coloradoprintingproject/twoolhead/media/photo/crowdsupply_campaign_images/twaz-6-printing-brace1.jpg

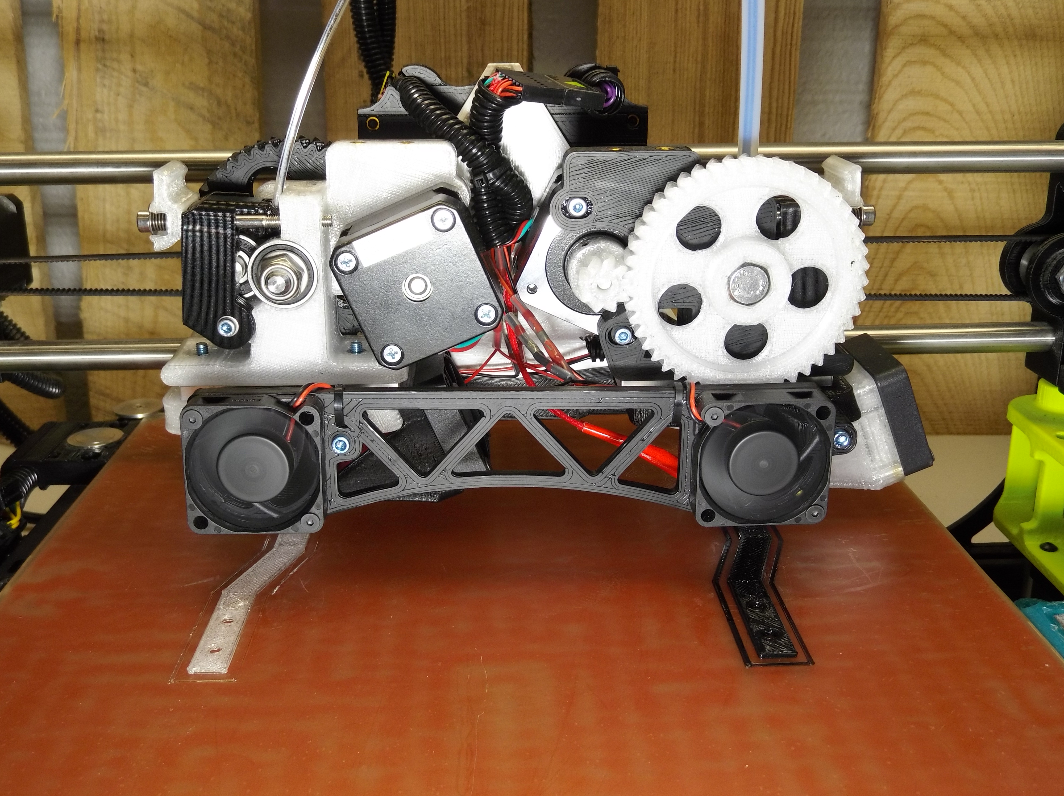
media/photo/crowdsupply_campaign_images/twaz-6-printing-brace1.jpg
