coloradoprintingproject/twoolhead/docs/twoolhead_greeting_letter.odt

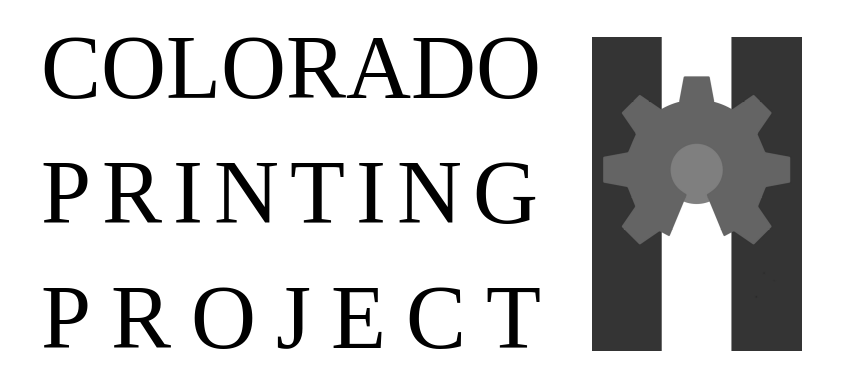
[picture p3: figure]

Thank you for purchasing the Twoolhead, and for supporting the development being done by the Colorado Printing Project.

This is version 1.1 of the Thoolhead, the first to incorporate E3D hotends nickel plated copper nozzles. Your Twoolhead is currently loaded with ABS filament, and the package contains 2 nozzle cleaning brushes that were printed simultaneously using your Twoolhead as a final quality check prior to shipping.

To get started, please download the Twoolhead source from Github by navigating to the link below and clicking on the green “clone or download” button. This will include a complete startup guide in the getting_started folder, along with the part files, bill of materials and all other source materials created during development. There are also video tutorials up on the Colorado Printing Project’s YouTube chanel.

https://github.com/coloradoprintingproject/twoolhead

The Twoolhead will work with pretty much any slicing software, but needs custom start and end gcode which is included in the startup guide.

If you have any questions or difficulties getting started, please get in touch with me directly at bam@coloradoprintingproject.org.

Again, thank you for your support of the Colorado Printing Project

-Brent MacKenzie (bam)

Founder

Colorado Printing Project, Ltd.

Copyright 2018 by the Colorado Printing Project CC-BY-SA 4.0
