coloradoprintingproject/twoolhead/media/video_outline.odt

1. Opening: Batch 3D printing is awesome, get in on it.

Image: Show clips of existing 3D printer clusters (lulzbot, Prusa research) and cool 3D printing projects (LEGO longboard, OpenBCI).

Text: 3D printing for small batch production is quickly lowering the barrier to entry for getting a product to market in both cost and lead time, speeding up innovation and encouraging local manufacturing.

2. Beauty shot of Twoolhead. About ten seconds.

Image: Crowdsupply image of twoolhead, then short video of printing plate of gears or something.

Text: The Twoolhead builds on one of the most reliable and versatile 3D printers available today and doubles it’s output.

3. Detail 1: About 15 seconds.

Image: Timelapse of twoolhead install on TAZ 6

Text: The twoolhead integrates seamlessly with LulzBot(R) TAZ 5 and 6 3D printers, some of the most heavily tested and used printers on the market. The Twoolhead comes with everything you need to get started in less than 20 minutes.

4. Detail 2: Output & materials. About 15 seconds.

Image: short clips of Twoolhead printing / finishing lots of different parts, gears, fan mounts, bottle openers, octopi, etc.

Text: With an output of nearly 700 grams per day of consumer grade printed plastic parts, the twoolhead makes small batch production easier than ever

Image: Image of Twoolhead on TAZ 6 with stacks of filament around it

Text: The twoolhead is capable of printing with nearly all FFF materials currently available, making it easy to print just the right parts as soon as you need them

5. Detail 3: Open-source. About 15 seconds.

Image: timelapse of twoolhead being assembled in blender

Text: The Twoolhead is fully open-source, and was developed using open source tools.

Image: Timelapse of browsing repo, including logo source and freeCAD source

Text: Having access to the source means that you can tweak, modify and upgrade your printhead over time

  6. Explain who you are… About 15 seconds.

Image: Gopro video

Audio: Heya this is bam with Colorado Printing Project, which is a company I started about 6 months ago designed to speed up the open source development of production oriented 3D printing. I was fortunate enough to spend the last 4 and a half years working in and designing parts for production in the cluster up at Aleph Object’s headquarters. This is a fantastic technology, and I really want to ensure that batch printing technology moves forward quickly and in a way where it isn’t crippled by patents.

The first step towards a fully production oriented machine has been to outfit one of the best production printers in the world with the twoolhead, doubling it’s output. I’m currently on the 3rd iteration prototype and the pre-production testing is going well. I have vendors lined up and am ready to produce the first batch of Twoolheads.

6. Make it clear that you need the viewers’ help, both in pledging to the project and in spreading the word. End with a clear call to action. About 15 seconds.

Image: Continued from previous.

Audio: I need your help turning this phase of the project into a product, and I will need help in order to continue development of production oriented 3D printing technology. Thanks for supporting the project and happy printing

End: show text of all required attribution
