coloradoprintingproject/twoolhead/media/logo/coprintpro_logo.pdf

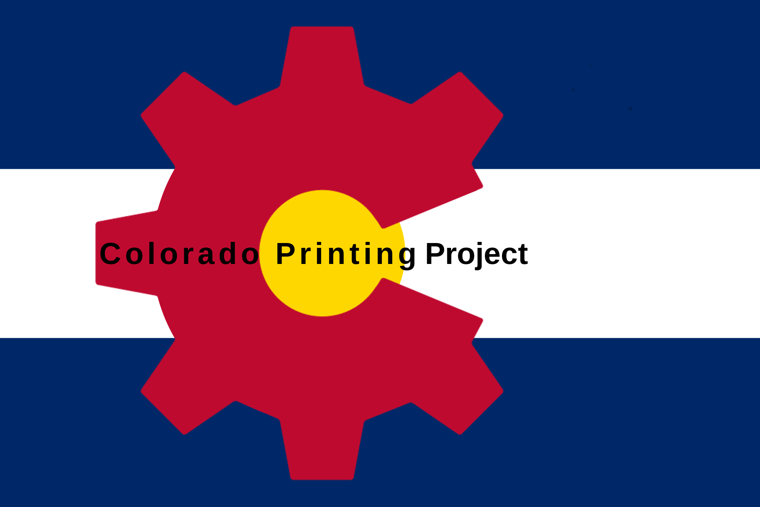
[picture p4: page 1]

Colorado Printing Project
