coloradoprintingproject/twoolhead/docs/twaz_vs_injection-molding.png

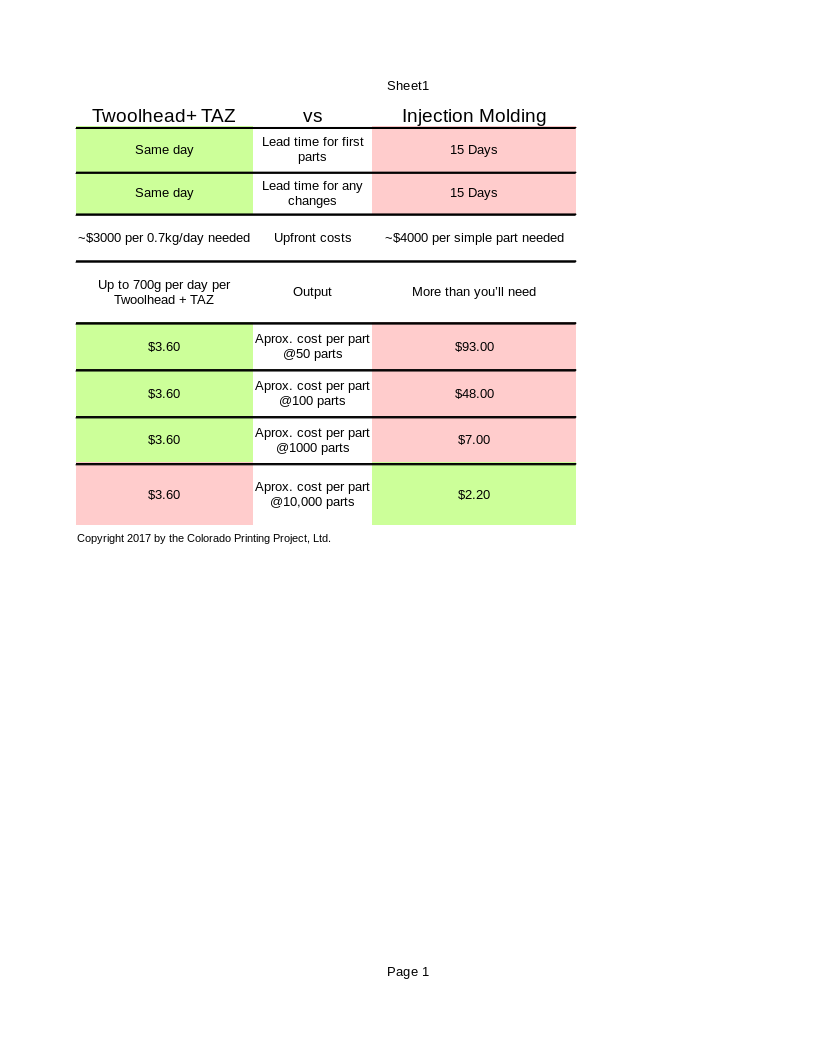
docs/twaz_vs_injection-molding.png
