coloradoprintingproject/twoolhead/media/cad_render/embeefened_twoolhead.JPG

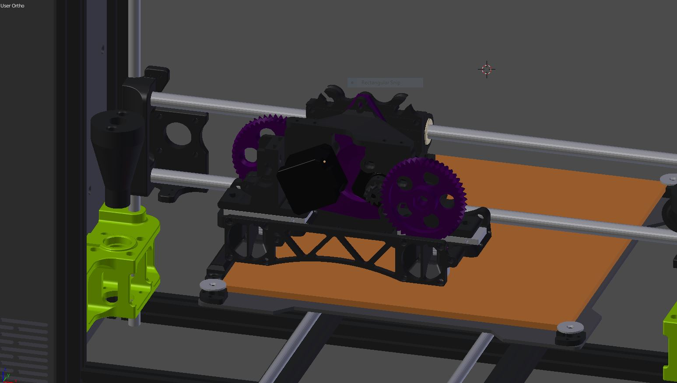
media/cad_render/embeefened_twoolhead.JPG
