coloradoprintingproject/twoolhead/media/cad_render/twoolhead_bracing_blender_mockup.JPG

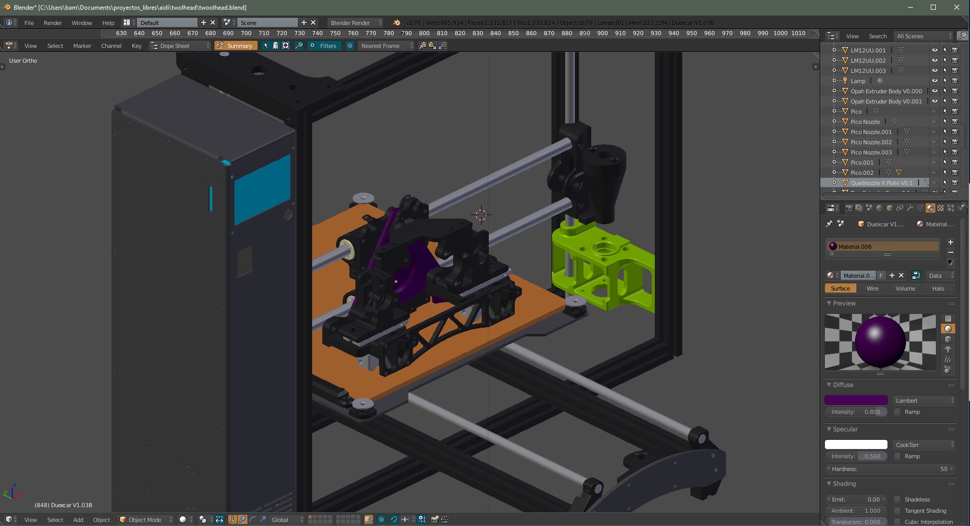
media/cad_render/twoolhead_bracing_blender_mockup.JPG
