coloradoprintingproject/twoolhead/media/new-cura-machine-settings.png

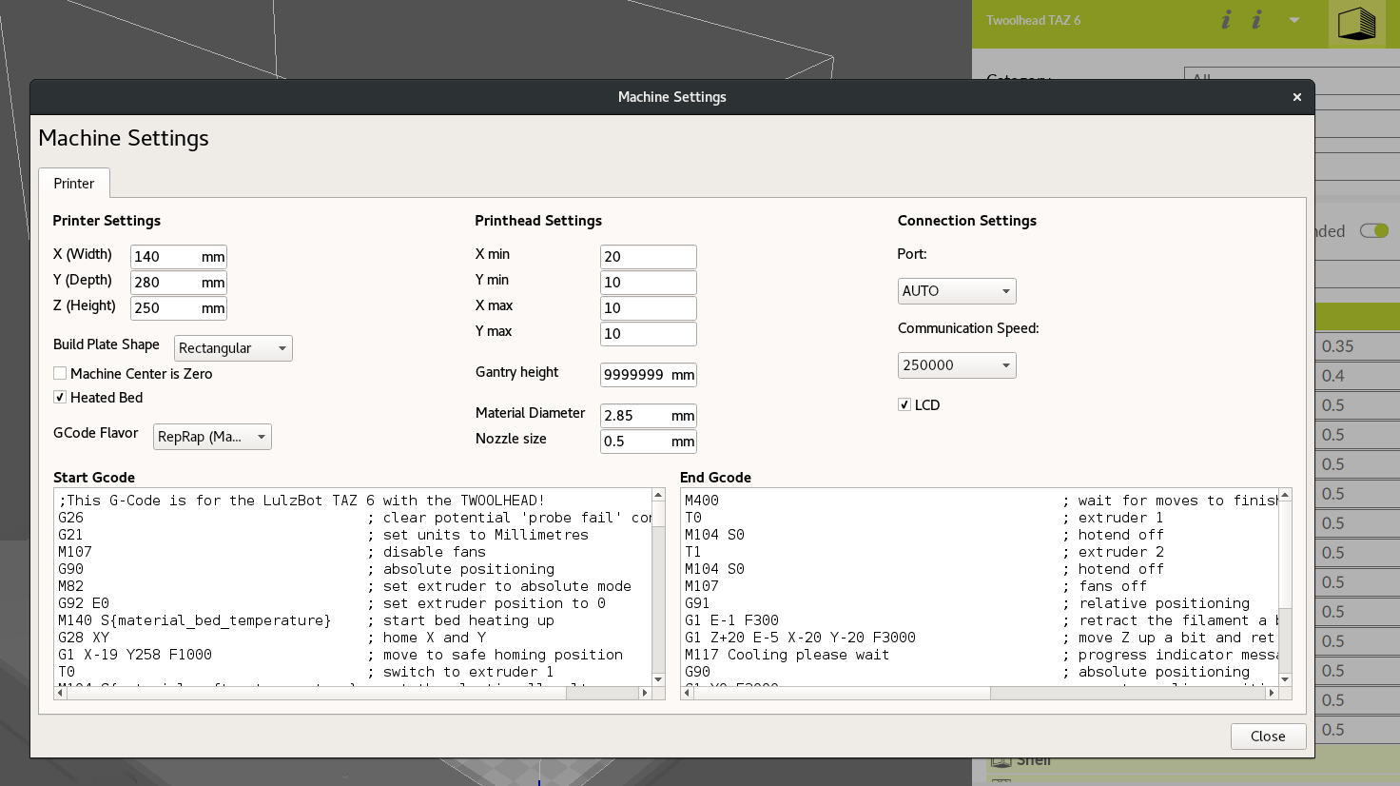
media/new-cura-machine-settings.png
