coloradoprintingproject/twoolhead/media/photo/alpha_prototype_images/twoolhead_front.jpg

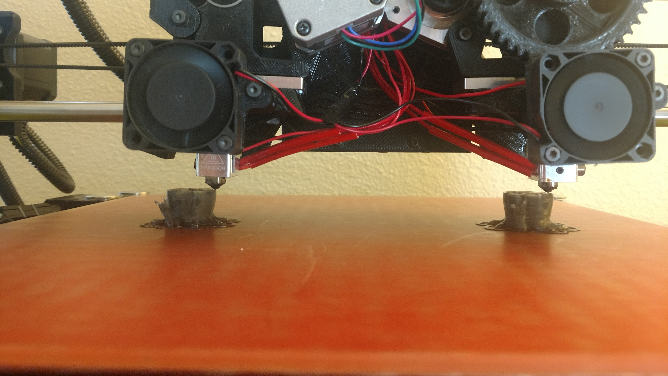
media/photo/alpha_prototype_images/twoolhead_front.jpg
