coloradoprintingproject/twoolhead/media/photo/alpha_prototype_images/twoolhead_top.jpg

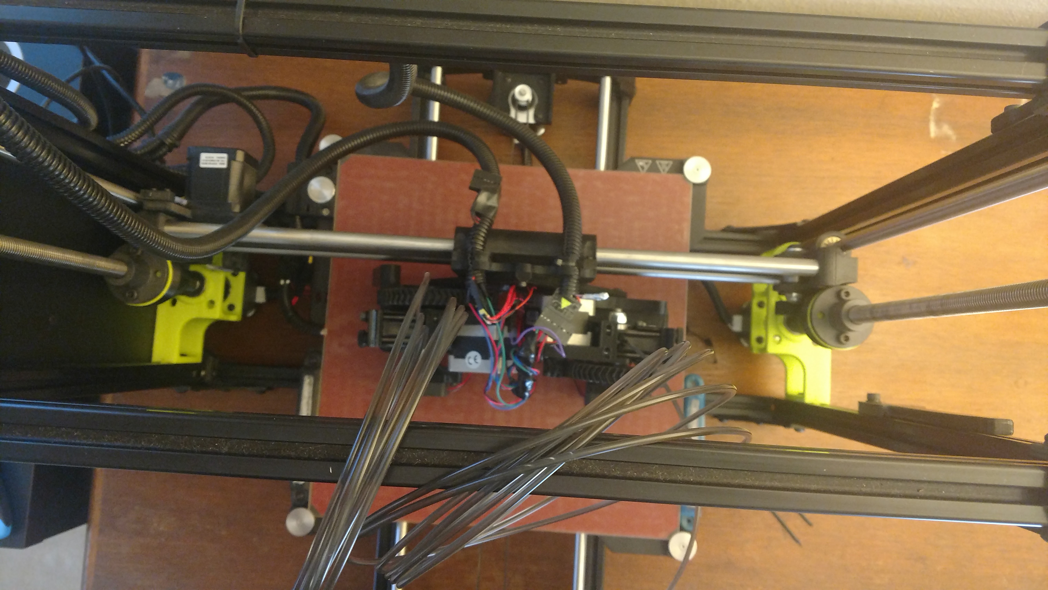
media/photo/alpha_prototype_images/twoolhead_top.jpg
