coloradoprintingproject/twoolhead/media/photo/alpha_prototype_images/twoolheat_front_wide.jpg

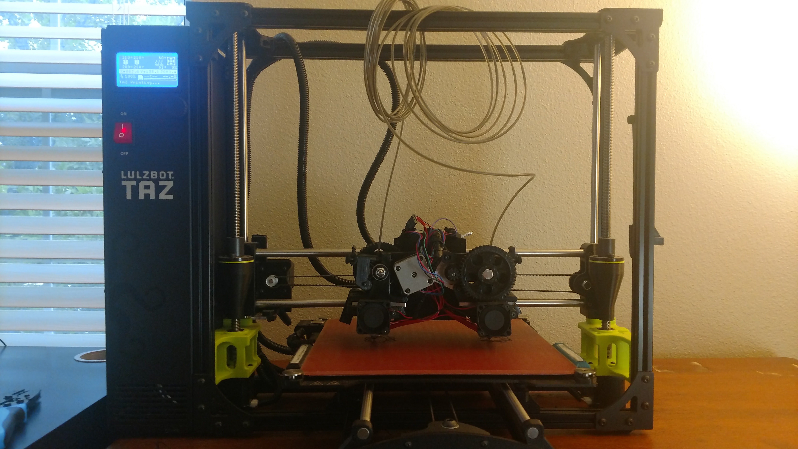
media/photo/alpha_prototype_images/twoolheat_front_wide.jpg
