coloradoprintingproject/twoolhead/media/photo/beta_prototype_images/1.jpg

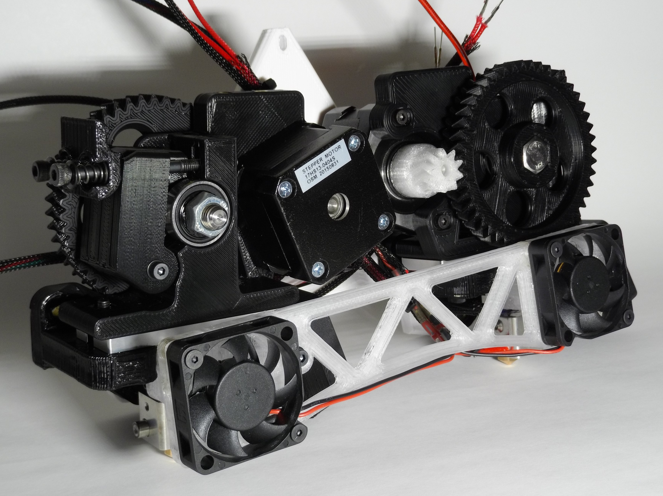
media/photo/beta_prototype_images/1.jpg
