coloradoprintingproject/twoolhead/media/photo/beta_prototype_images/2.jpg

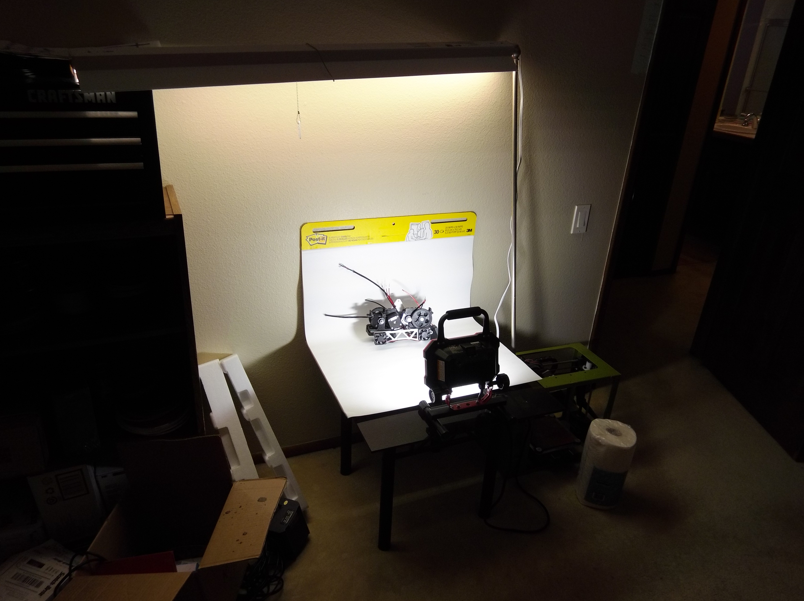
media/photo/beta_prototype_images/2.jpg
