coloradoprintingproject/twoolhead/media/photo/beta_prototype_images/3.jpg

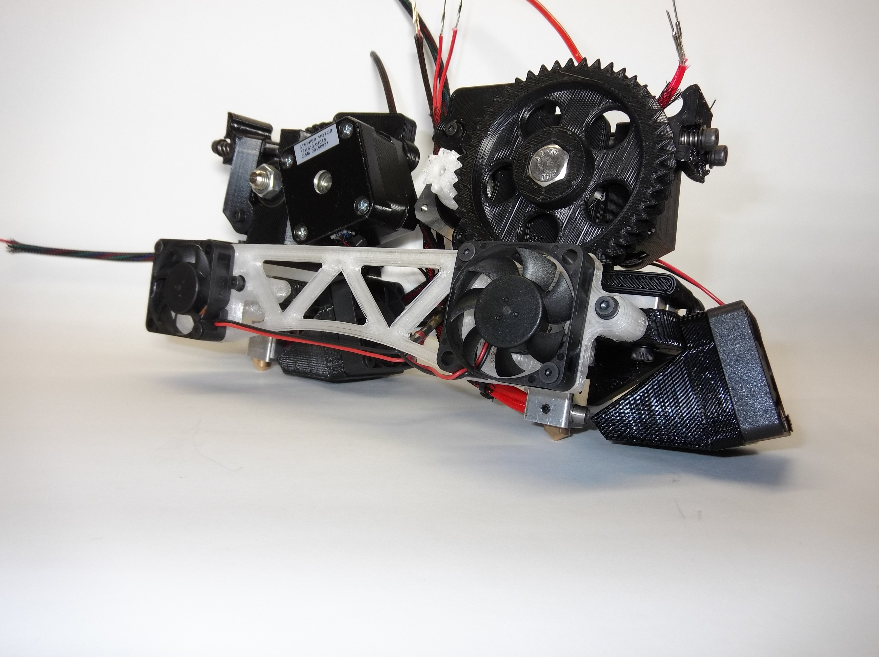
media/photo/beta_prototype_images/3.jpg
