coloradoprintingproject/twoolhead/media/photo/beta_prototype_images/4.jpg

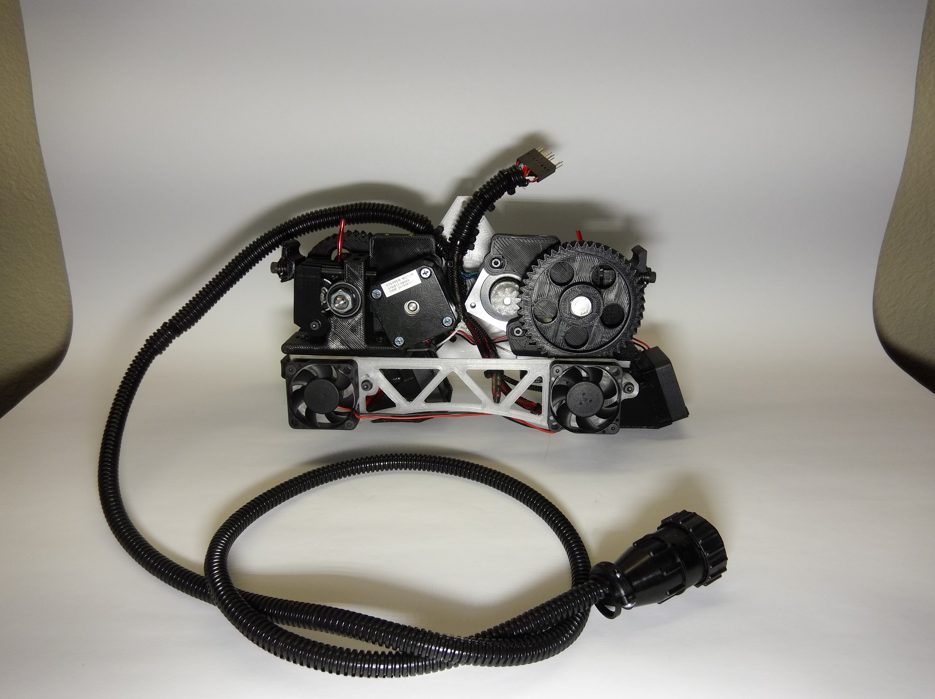
media/photo/beta_prototype_images/4.jpg
