coloradoprintingproject/twoolhead/media/photo/beta_prototype_images/5.jpg

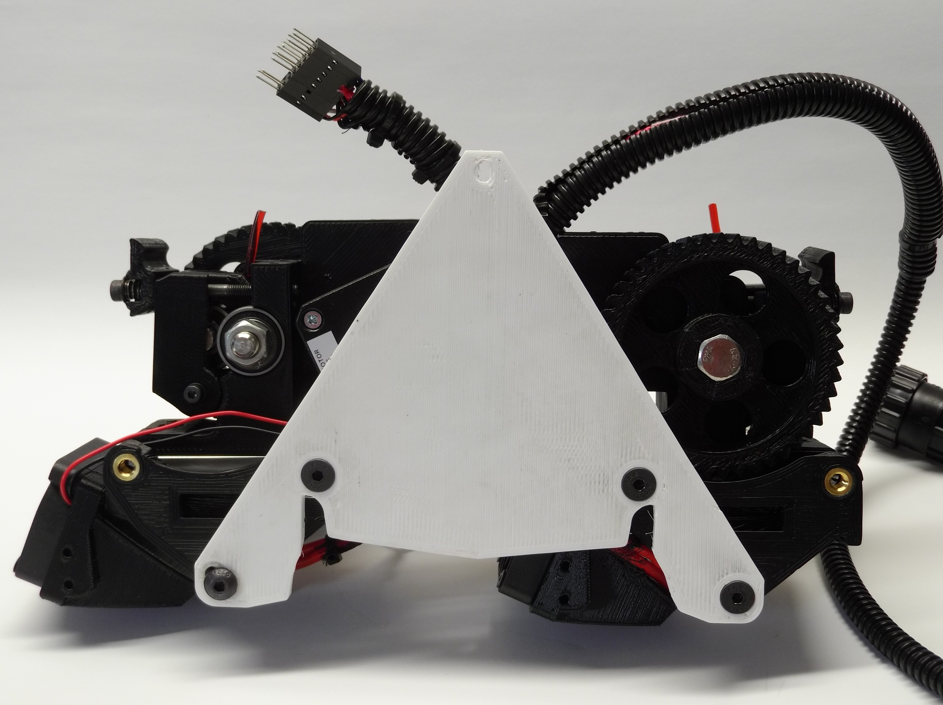
media/photo/beta_prototype_images/5.jpg
