coloradoprintingproject/twoolhead/media/photo/beta_prototype_images/6.jpg

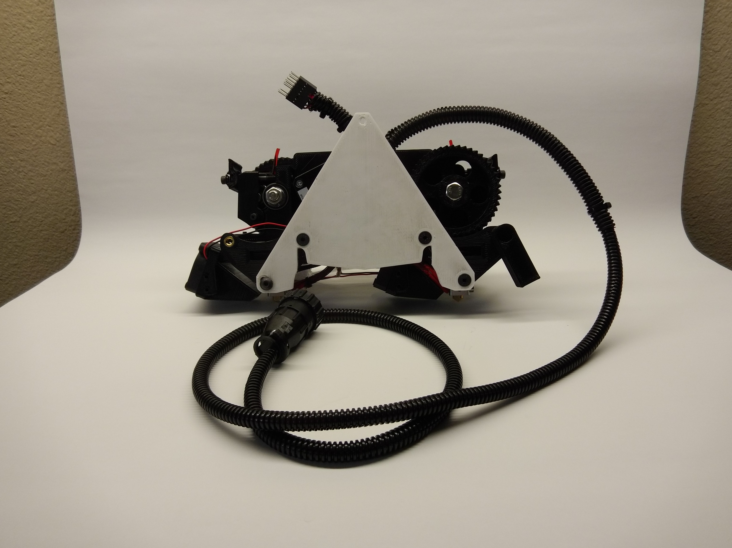
media/photo/beta_prototype_images/6.jpg
