coloradoprintingproject/twoolhead/media/photo/beta_prototype_images/7.jpg

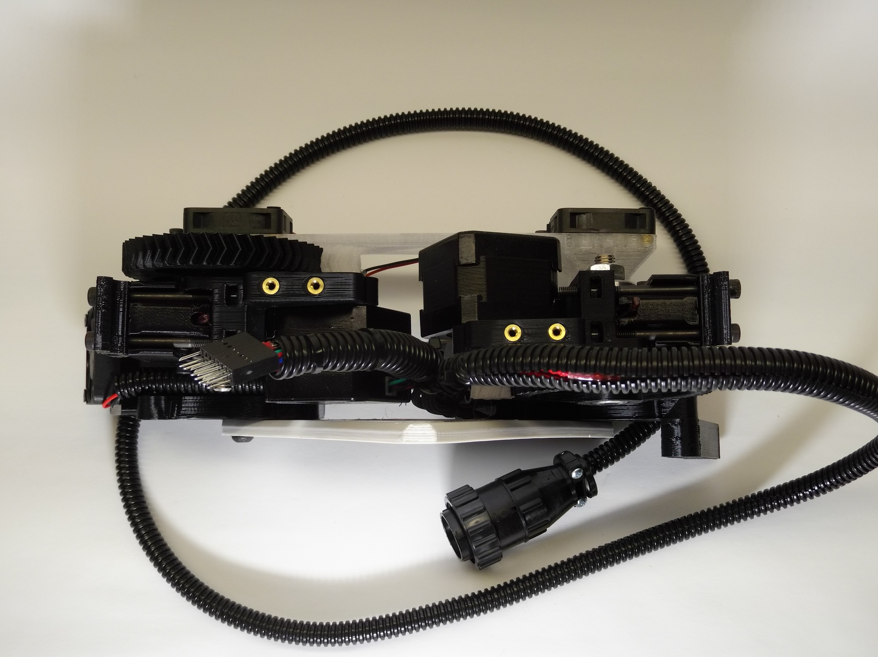
media/photo/beta_prototype_images/7.jpg
