coloradoprintingproject/twoolhead/media/photo/beta_prototype_images/crowdsupply_prelaunch_image.jpg

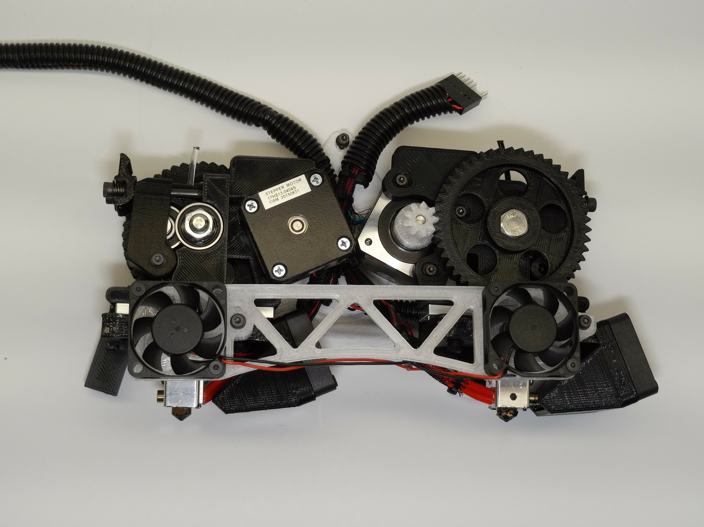
media/photo/beta_prototype_images/crowdsupply_prelaunch_image.jpg
