coloradoprintingproject/twoolhead/media/photo/crowdsupply_campaign_images/a-wild-twoolhead.jpeg

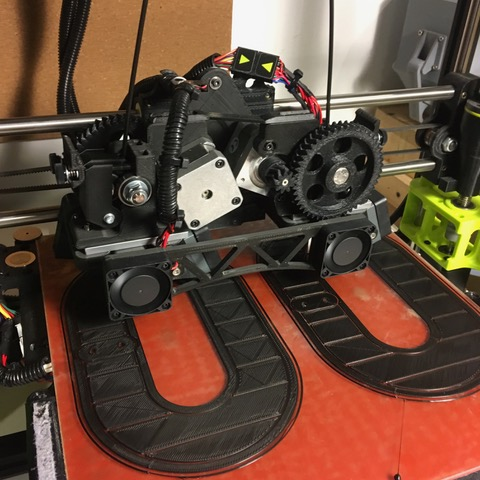
media/photo/crowdsupply_campaign_images/a-wild-twoolhead.jpeg
