coloradoprintingproject/twoolhead/media/photo/crowdsupply_campaign_images/blender-mesh-view.png

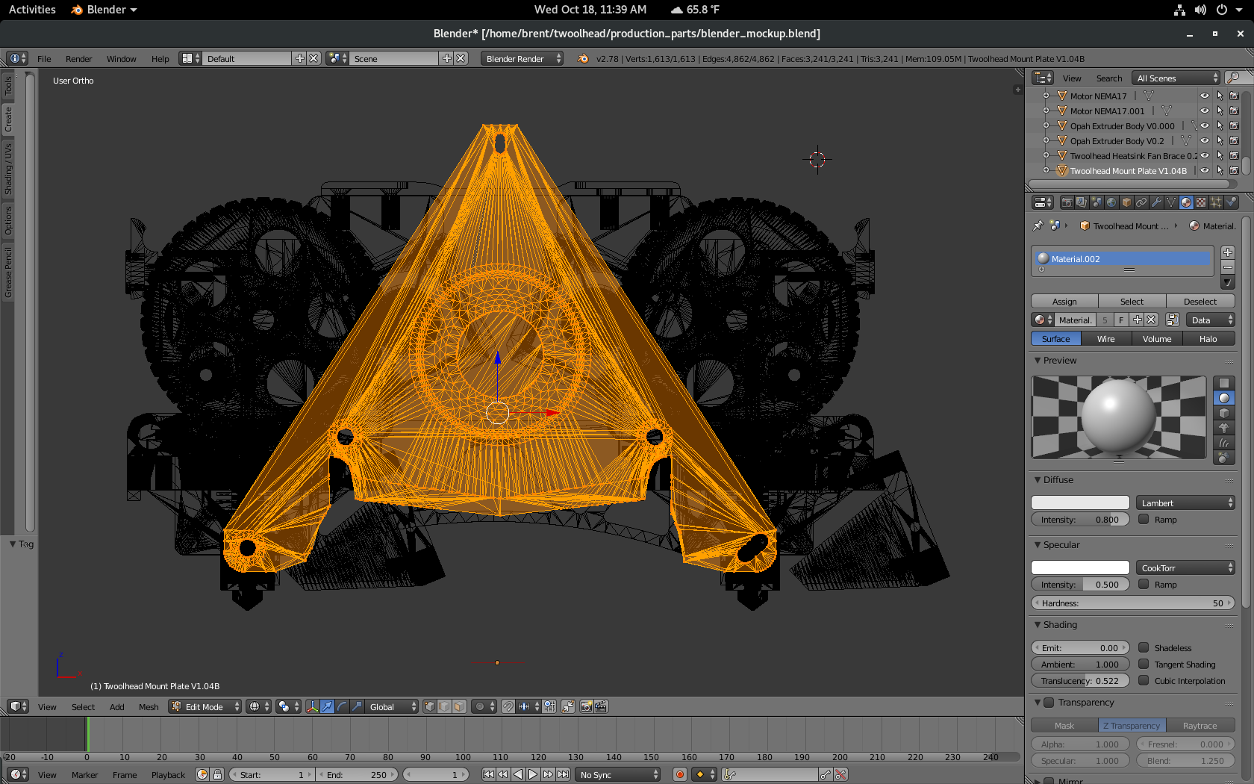
media/photo/crowdsupply_campaign_images/blender-mesh-view.png
