coloradoprintingproject/twoolhead/media/photo/crowdsupply_campaign_images/blender-mockup.png

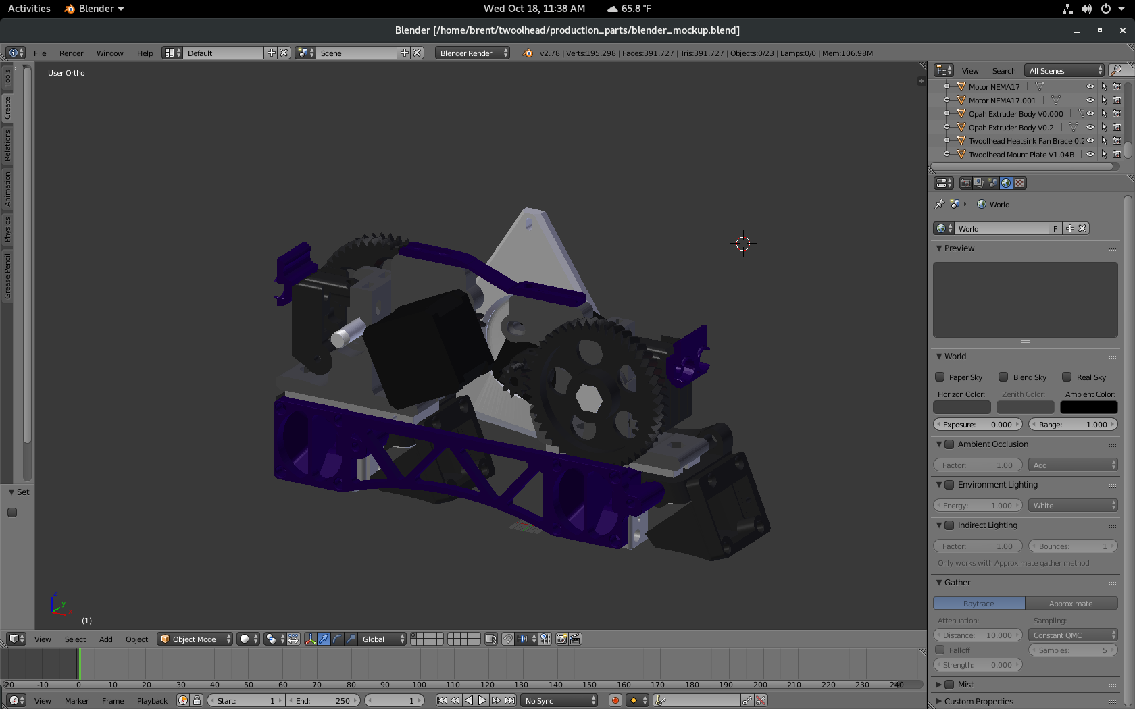
media/photo/crowdsupply_campaign_images/blender-mockup.png
