coloradoprintingproject/twoolhead/media/photo/crowdsupply_campaign_images/freecad-screenshot.png

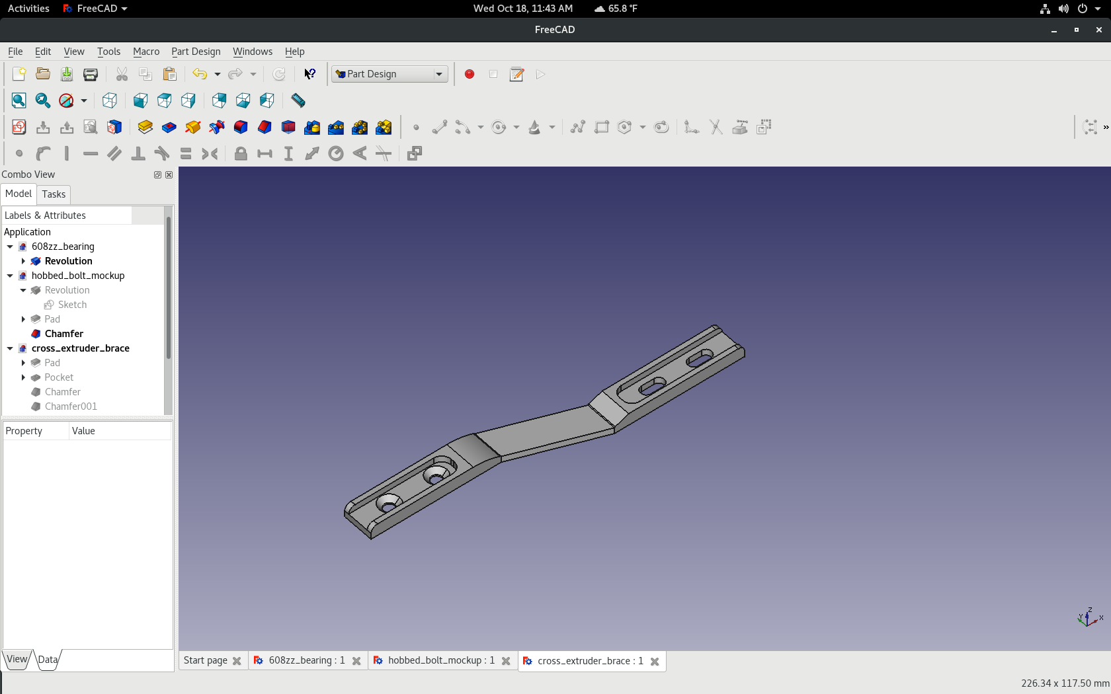
media/photo/crowdsupply_campaign_images/freecad-screenshot.png
