coloradoprintingproject/twoolhead/media/photo/crowdsupply_campaign_images/metric-blue-and-colorado-purp.jpg

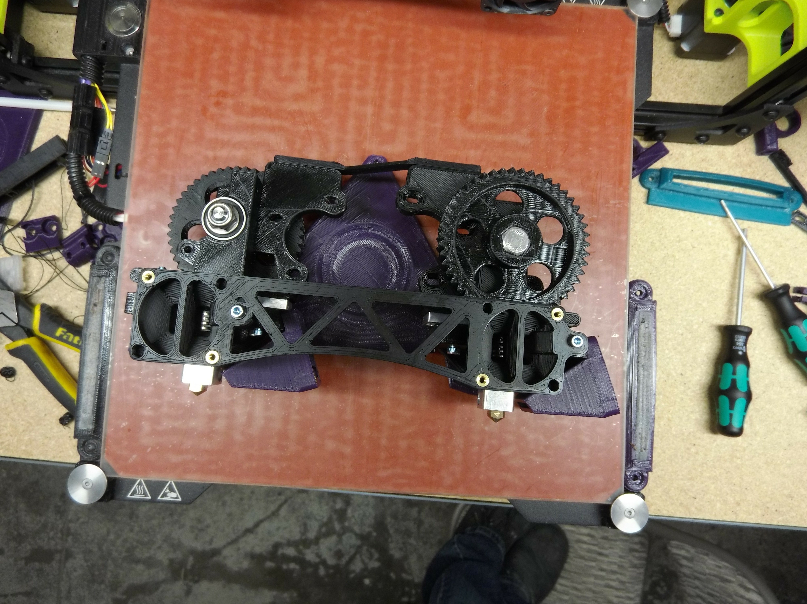
media/photo/crowdsupply_campaign_images/metric-blue-and-colorado-purp.jpg
