coloradoprintingproject/twoolhead/media/photo/crowdsupply_campaign_images/twaz-6-mounted2.jpg

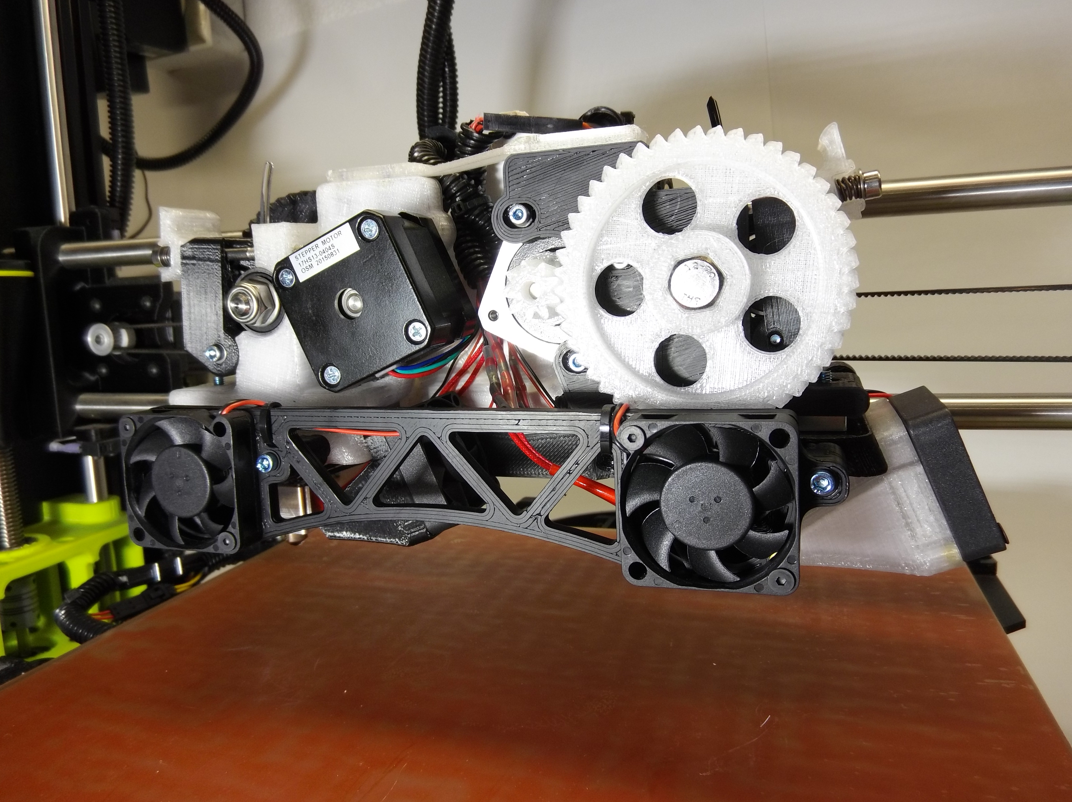
media/photo/crowdsupply_campaign_images/twaz-6-mounted2.jpg
