coloradoprintingproject/twoolhead/media/photo/crowdsupply_campaign_images/twaz-6-mounted-front-close.jpg

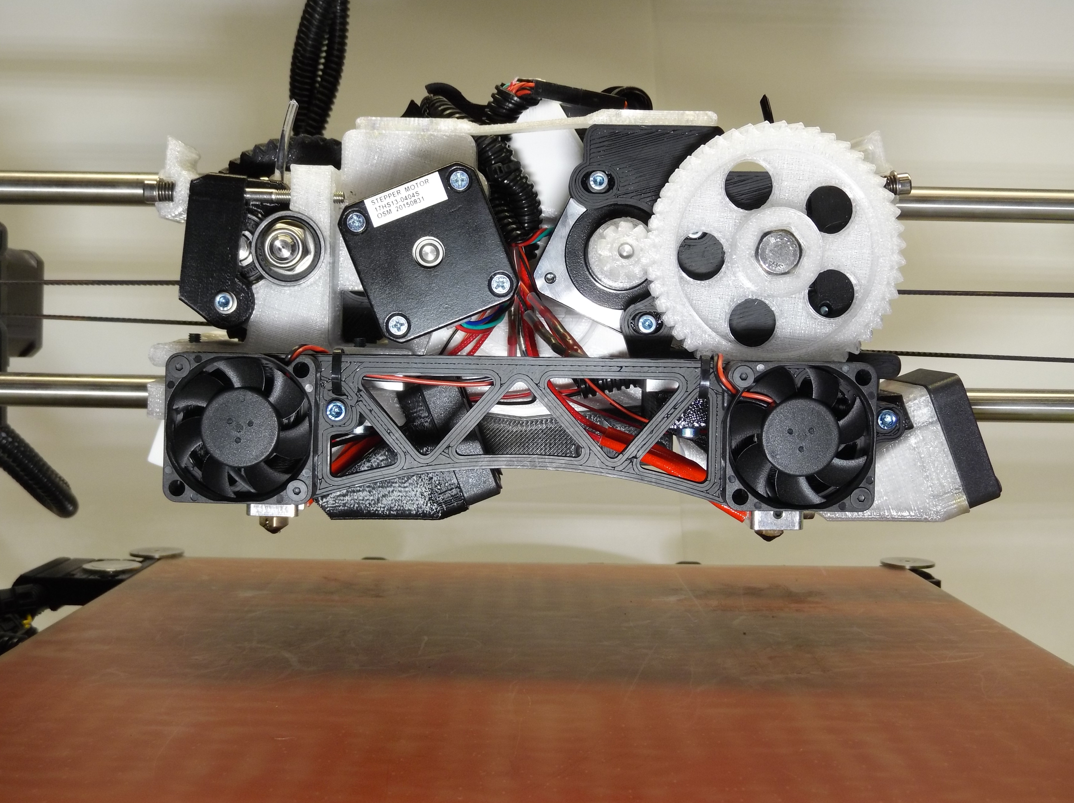
media/photo/crowdsupply_campaign_images/twaz-6-mounted-front-close.jpg
