coloradoprintingproject/twoolhead/media/photo/crowdsupply_campaign_images/twaz-6-mounted-front-left.jpg

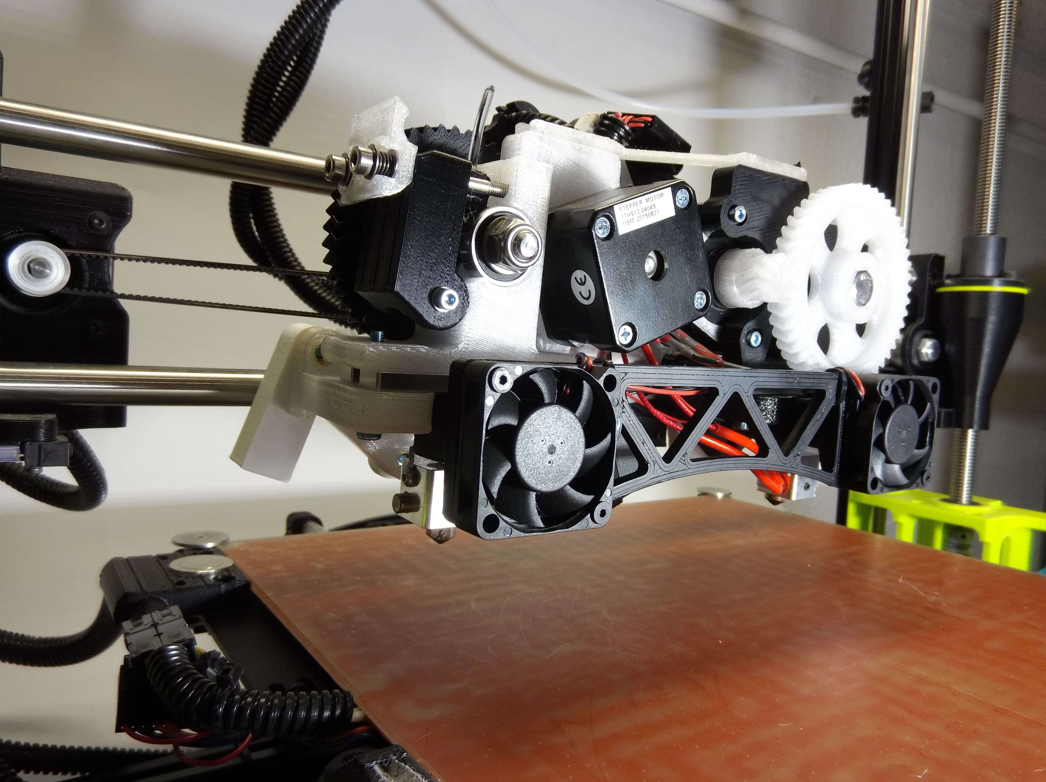
media/photo/crowdsupply_campaign_images/twaz-6-mounted-front-left.jpg
