coloradoprintingproject/twoolhead/media/photo/crowdsupply_campaign_images/twaz-6-mounted-front.jpg

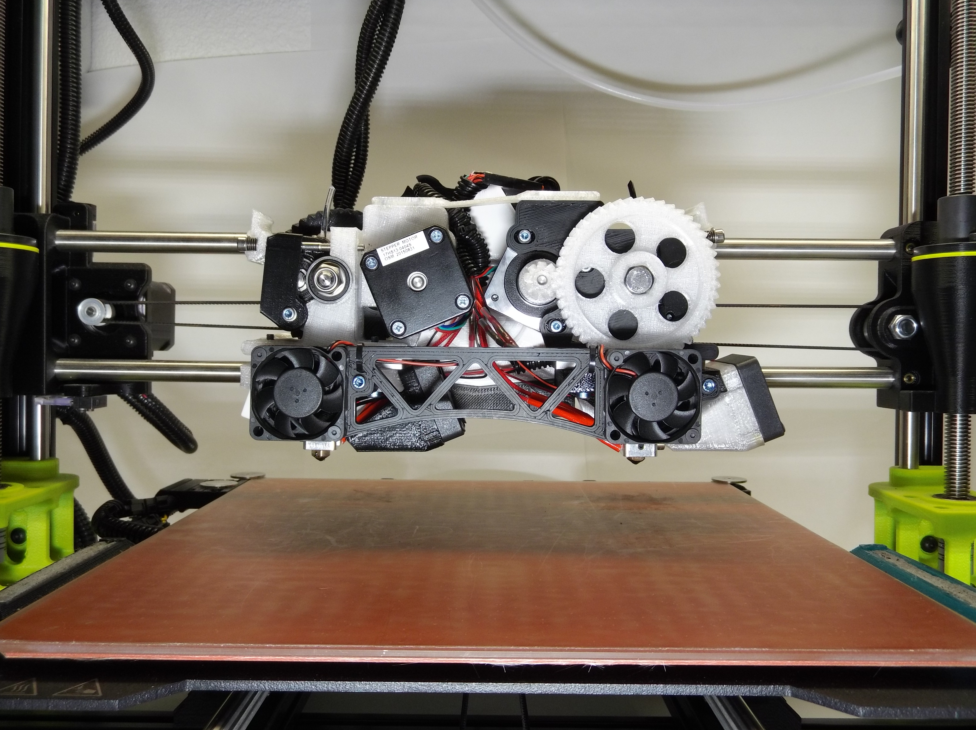
media/photo/crowdsupply_campaign_images/twaz-6-mounted-front.jpg
