coloradoprintingproject/twoolhead/media/photo/crowdsupply_campaign_images/twaz-6-mounted-top.jpg

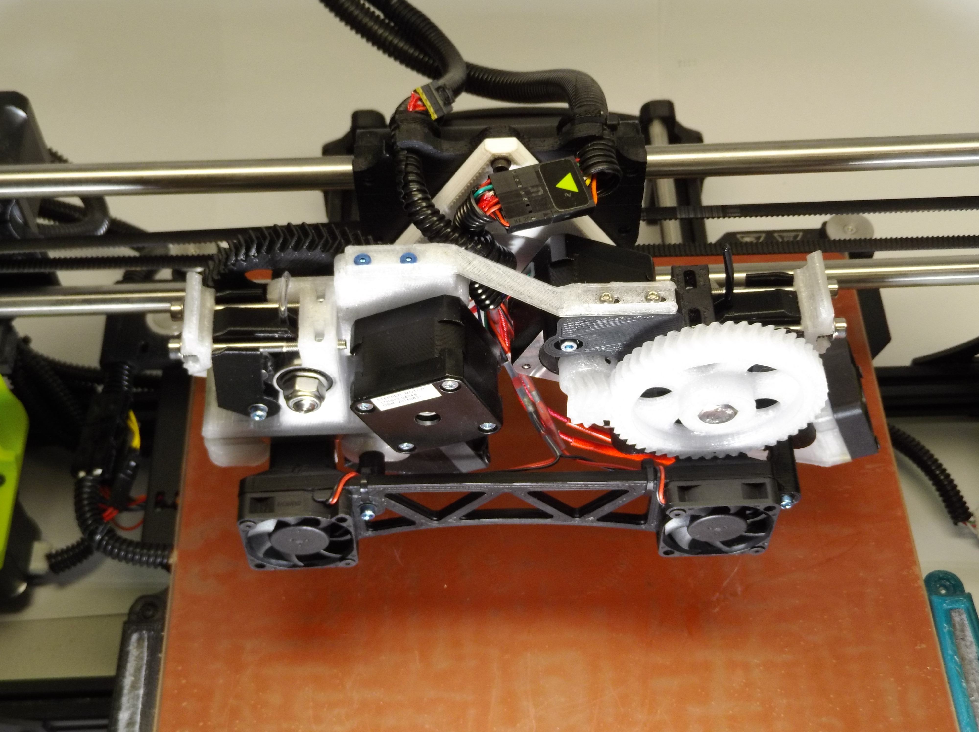
media/photo/crowdsupply_campaign_images/twaz-6-mounted-top.jpg
