coloradoprintingproject/twoolhead/media/photo/crowdsupply_campaign_images/twoolhead-back1.jpg

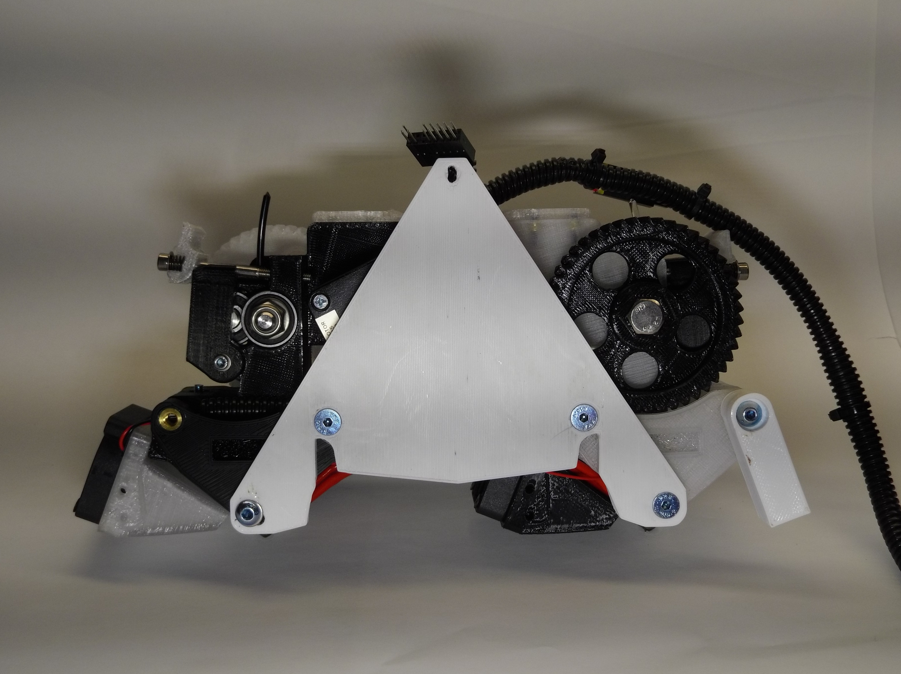
media/photo/crowdsupply_campaign_images/twoolhead-back1.jpg
