coloradoprintingproject/twoolhead/media/photo/crowdsupply_campaign_images/twoolhead-back2.jpg

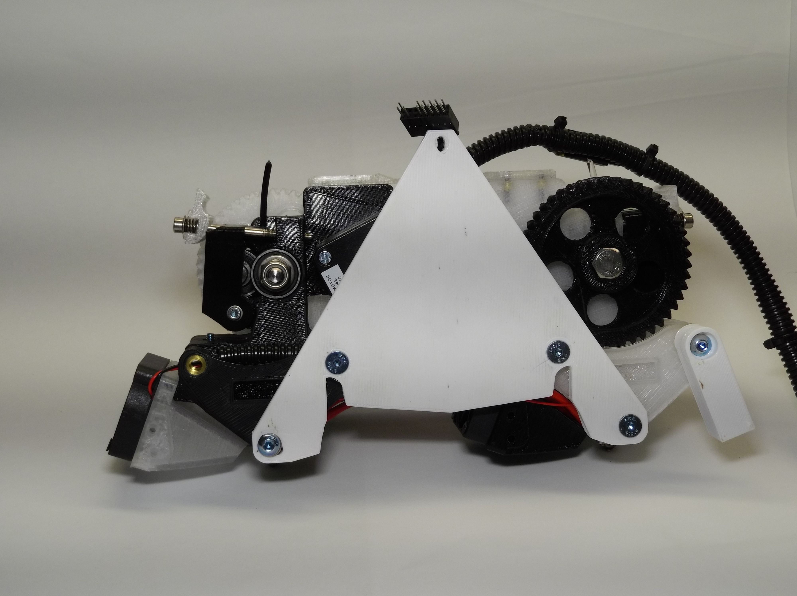
media/photo/crowdsupply_campaign_images/twoolhead-back2.jpg
