coloradoprintingproject/twoolhead/media/photo/crowdsupply_campaign_images/twoolhead-back3.jpg

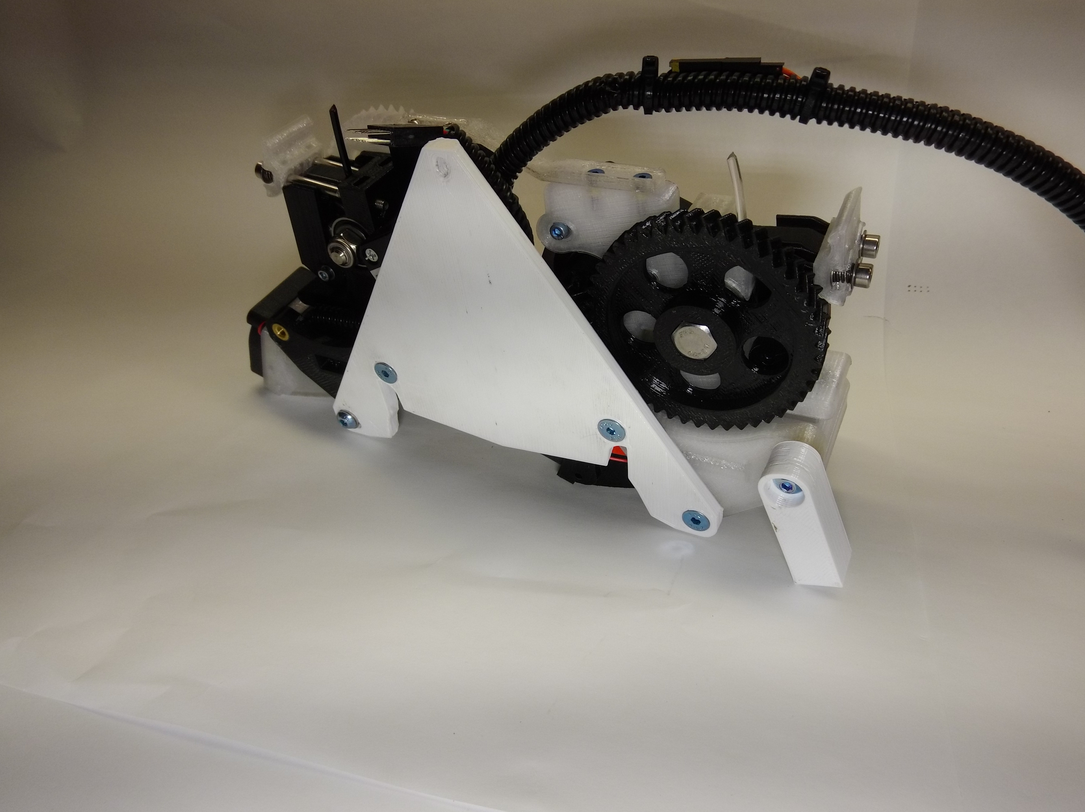
media/photo/crowdsupply_campaign_images/twoolhead-back3.jpg
