coloradoprintingproject/twoolhead/media/photo/crowdsupply_campaign_images/twoolhead-front2.jpg

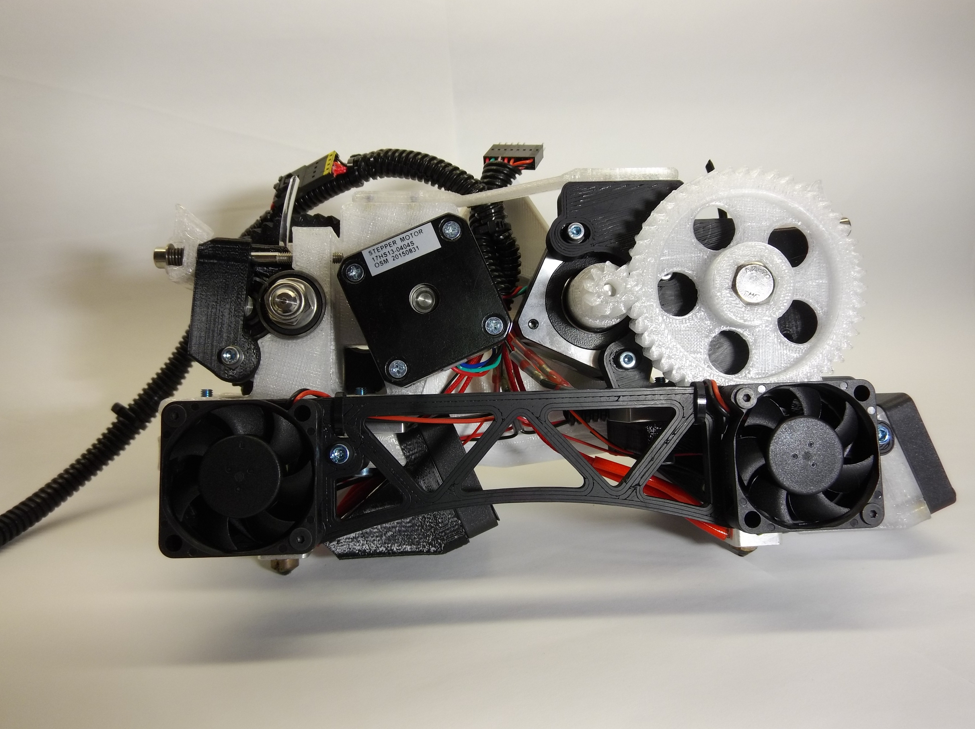
media/photo/crowdsupply_campaign_images/twoolhead-front2.jpg
