coloradoprintingproject/twoolhead/media/photo/crowdsupply_campaign_images/twoolhead-front-left1.jpg

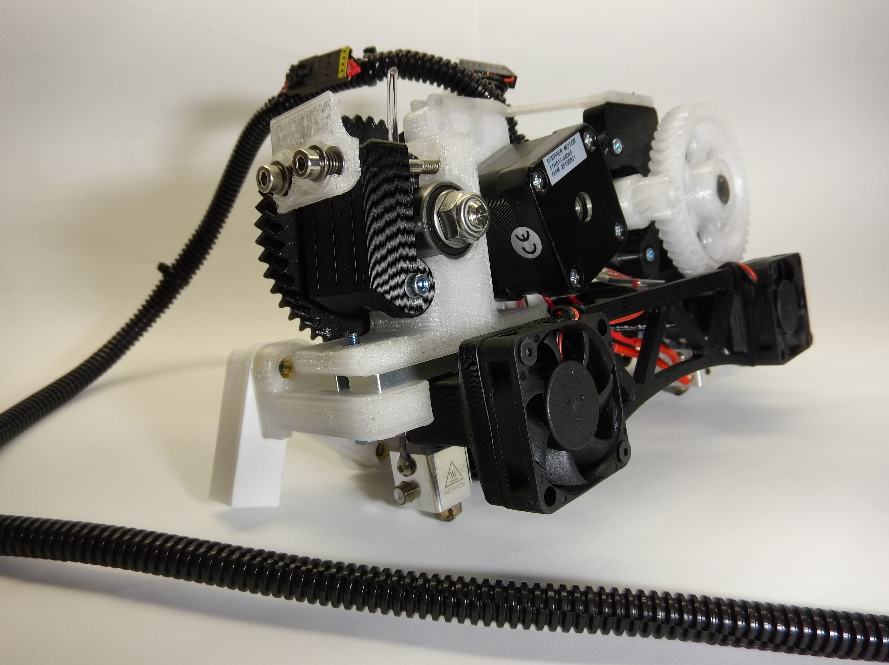
media/photo/crowdsupply_campaign_images/twoolhead-front-left1.jpg
