coloradoprintingproject/twoolhead/media/photo/crowdsupply_campaign_images/twoolhead-front-left.jpg

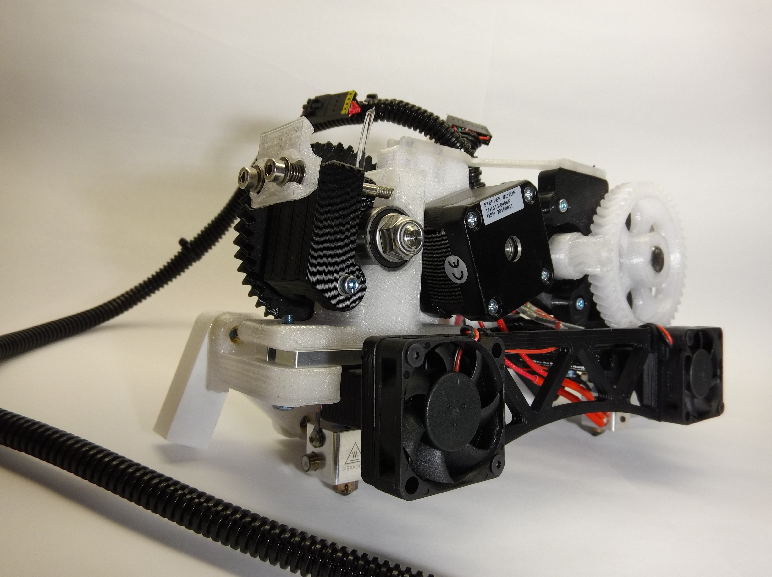
media/photo/crowdsupply_campaign_images/twoolhead-front-left.jpg
