coloradoprintingproject/twoolhead/media/photo/crowdsupply_campaign_images/twoolhead-front-right1.jpg

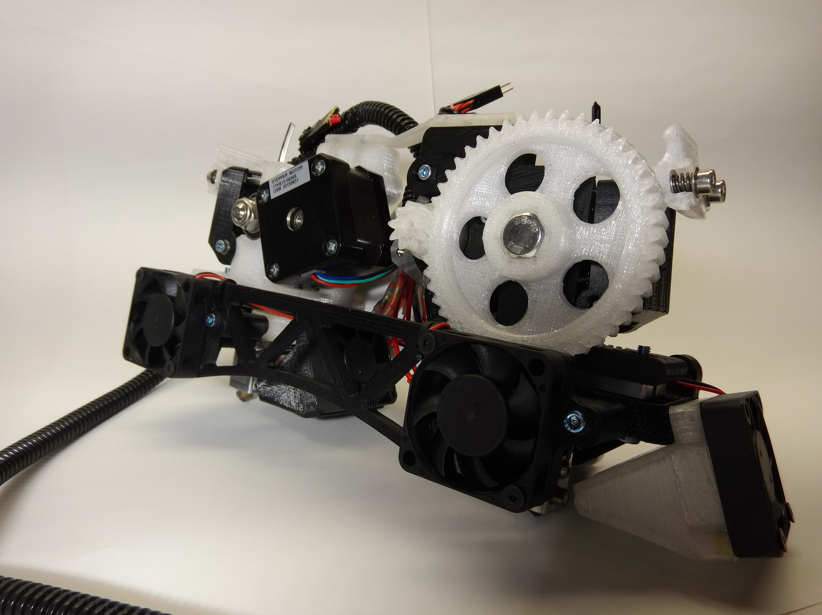
media/photo/crowdsupply_campaign_images/twoolhead-front-right1.jpg
