coloradoprintingproject/twoolhead/media/photo/crowdsupply_campaign_images/twoolhead-front-right2.jpg

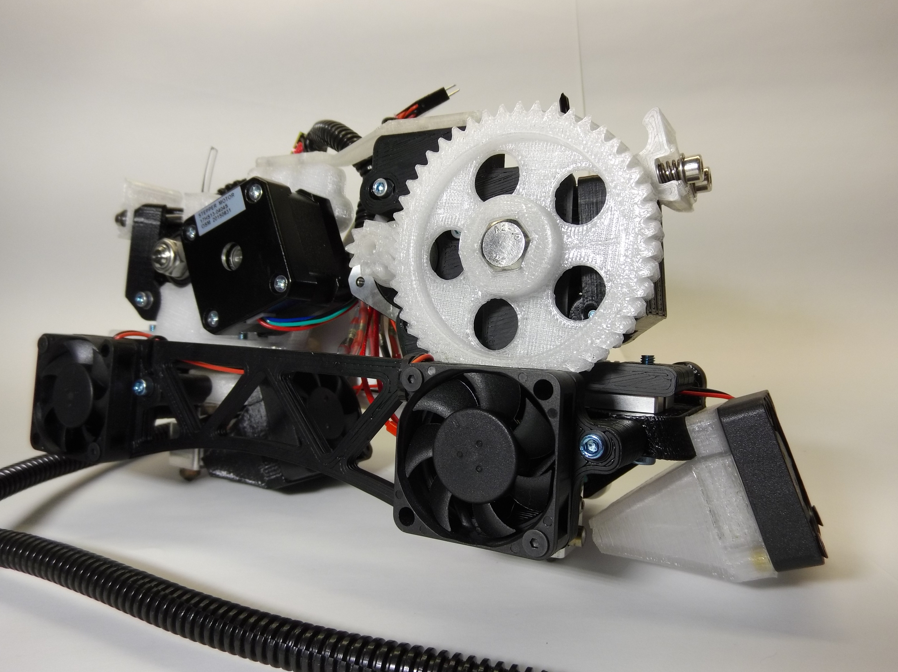
media/photo/crowdsupply_campaign_images/twoolhead-front-right2.jpg
