coloradoprintingproject/twoolhead/media/photo/crowdsupply_campaign_images/twoolhead-on-taz5.jpg

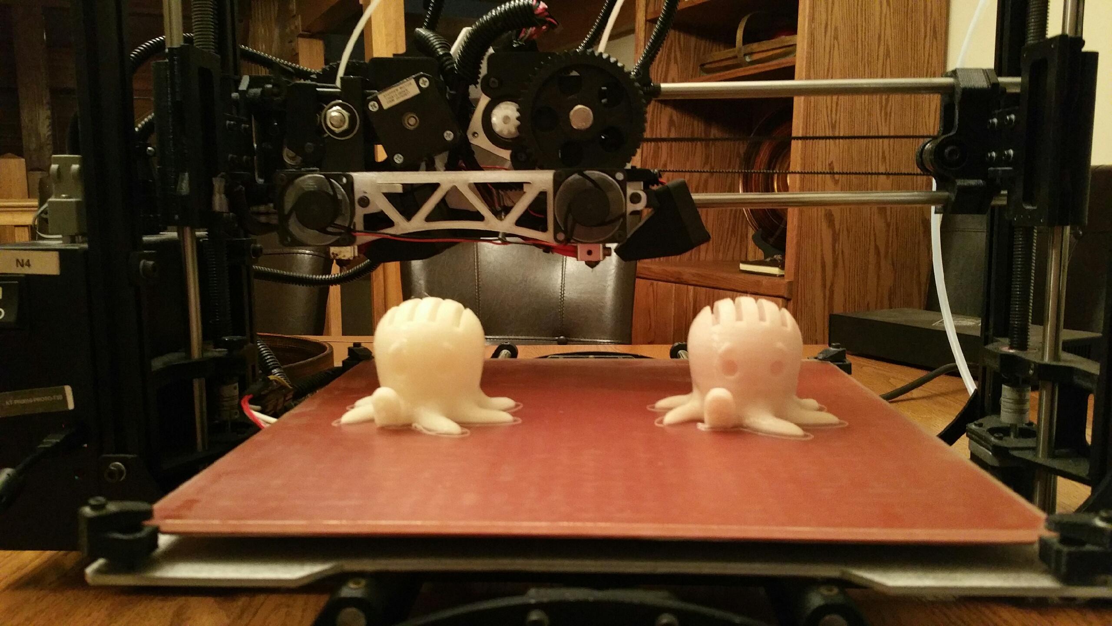
media/photo/crowdsupply_campaign_images/twoolhead-on-taz5.jpg
