coloradoprintingproject/twoolhead/media/photo/crowdsupply_campaign_images/twoolhead-prelaunch.jpg

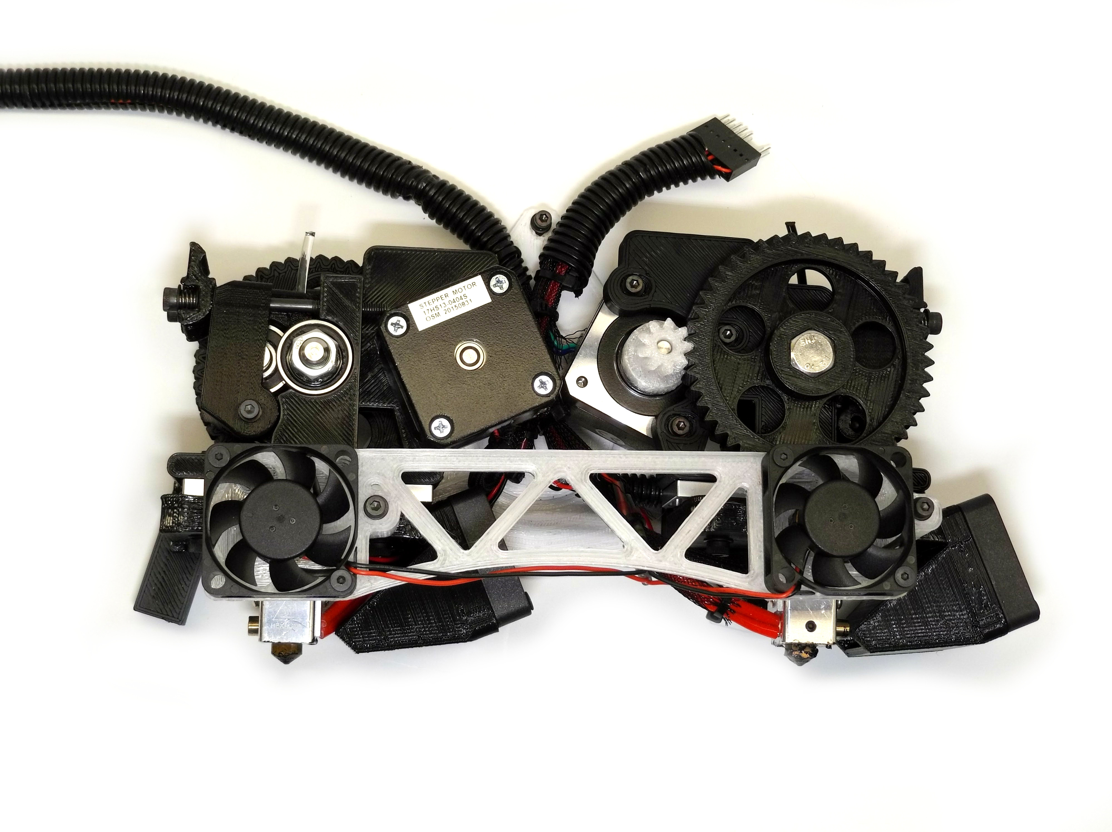
media/photo/crowdsupply_campaign_images/twoolhead-prelaunch.jpg
