coloradoprintingproject/twoolhead/media/photo/crowdsupply_campaign_images/twoolhead-top1.jpg

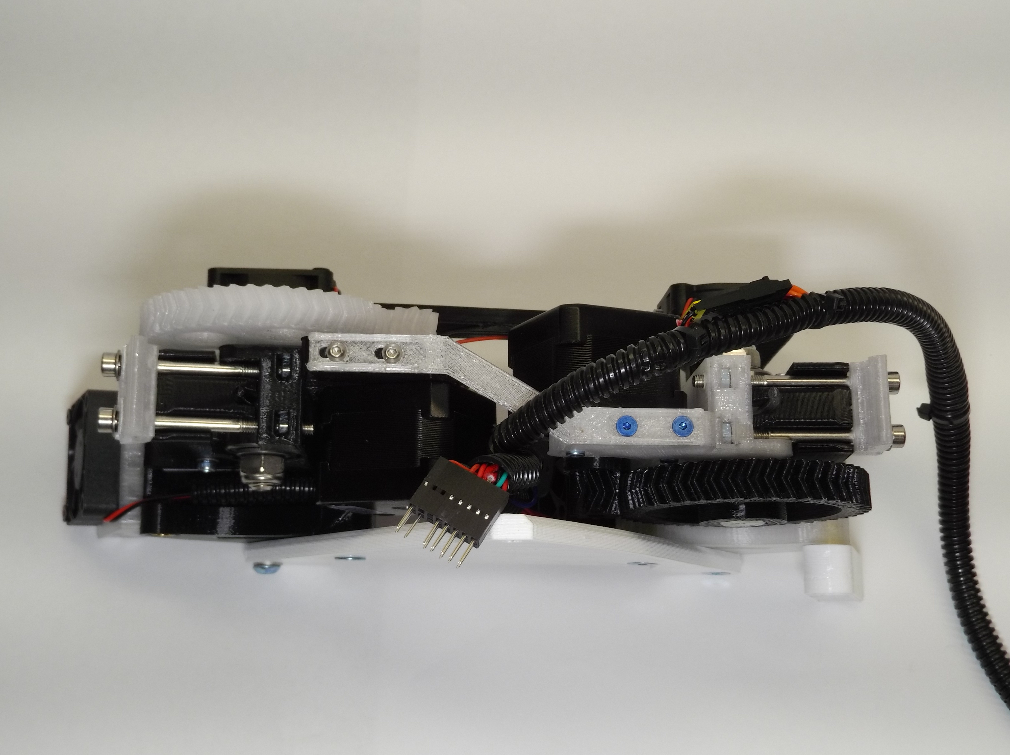
media/photo/crowdsupply_campaign_images/twoolhead-top1.jpg
