coloradoprintingproject/twoolhead/media/photo/crowdsupply_campaign_images/twoolhead-top2.jpg

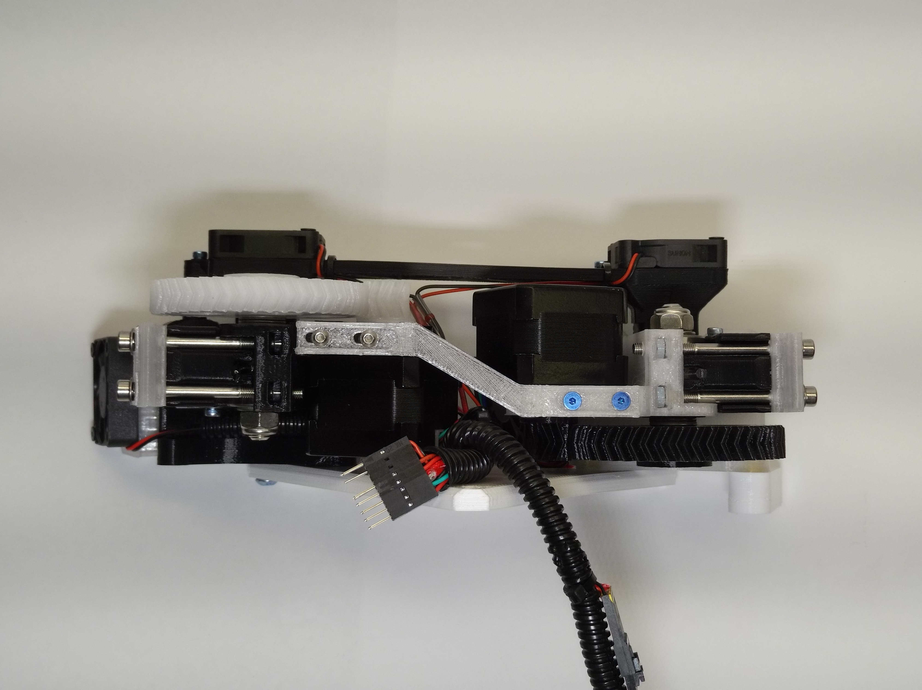
media/photo/crowdsupply_campaign_images/twoolhead-top2.jpg
