coloradoprintingproject/twoolhead/media/photo/crowdsupply_campaign_images/twwoolhead-front.jpg

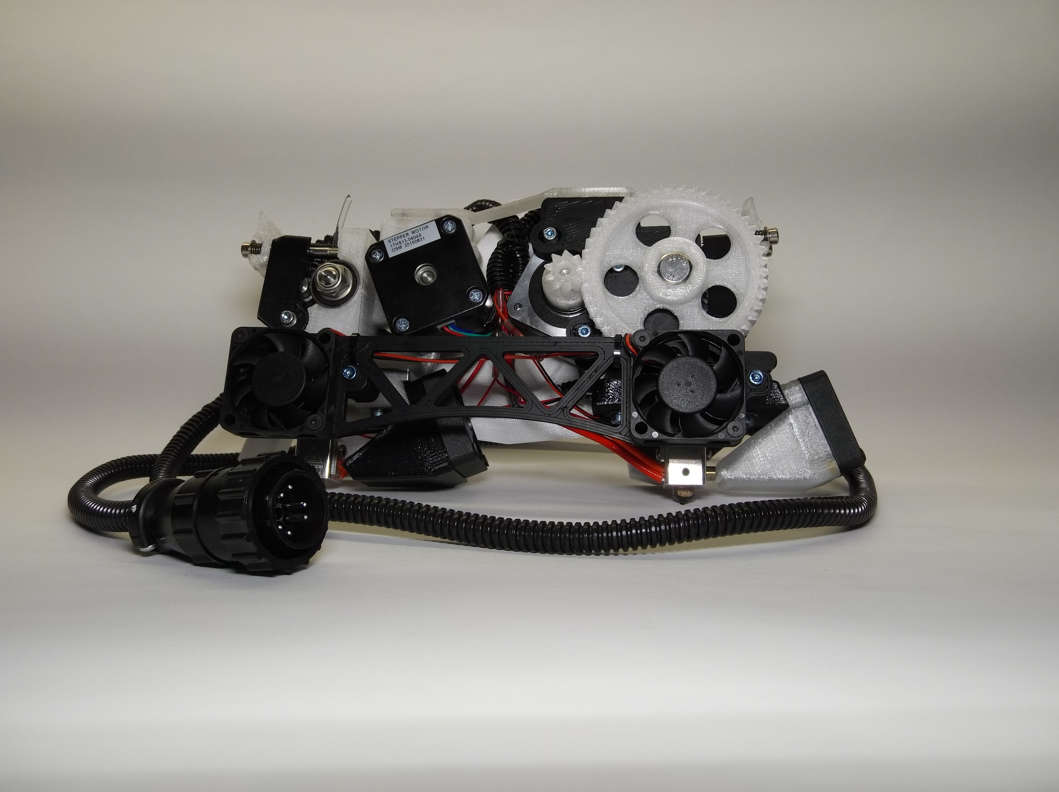
media/photo/crowdsupply_campaign_images/twwoolhead-front.jpg
