coloradoprintingproject/twoolhead/media/photo/twoolhead_v1.1/twoolhead-updated.JPG

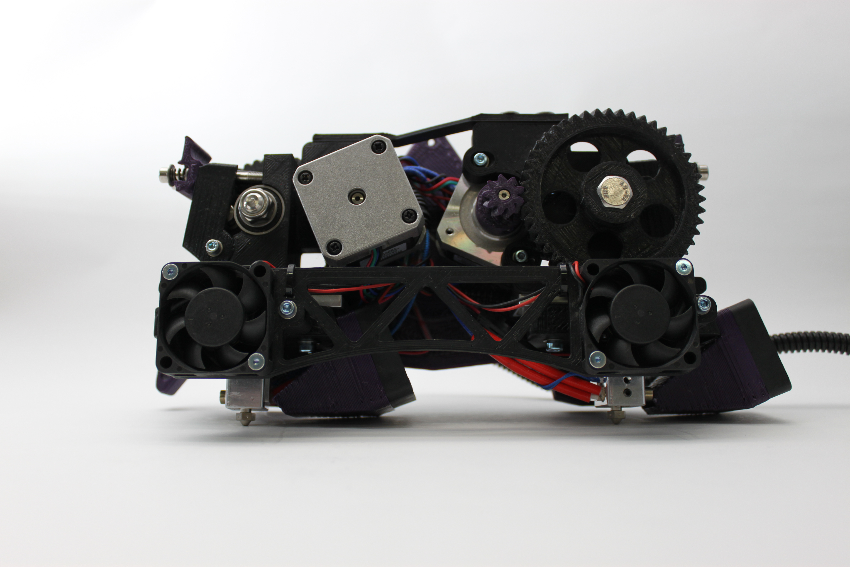
media/photo/twoolhead_v1.1/twoolhead-updated.JPG
