coloradoprintingproject/twoolhead/docs/twoolhead_bom.ods

Sheet: BOM
Copyright 2017 by the Colorado Printing Project, ltd. CC-BY-SA 4.0
twoolhead bom
vitamins
what is it? | how many? | where from? | how much? | for all of em? | qty discount (est)
stepper motor | 2 | https://www.omc-stepperonline.com/hybrid-stepper-motor/nema-17-bipolar-18deg-26ncm-368ozin-04a-12v-42x42x34mm-4-wires-17hs13-0404s1.html | $6.50 | $13.00 | $13.00
hobbed bolt | 2 | https://www.lulzbot.com/store/parts/hobbed-bolt-50mm-hex-head | $10.00 | $20.00 | $17.00
24v fans | 2 | https://www.lulzbot.com/store/parts/40mm-pelonis-low-flow-fan | $10.00 | $20.00 | $17.00
5v fans | 2 | https://www.lulzbot.com/store/parts/40mm-pelonis-low-flow-fan | $10.00 | $20.00 | $17.00
hotend | 2 | E3D | $75.00 | $150.00 | $150.00
male pins | 21 | http://www.digikey.com/product-detail/en/molex-llc/0016020107/WM2517CT-ND/467804 | $0.15 | $3.15 | $3.15
16 pin molex con | 2 | http://www.digikey.com/product-search/en?keywords=22552161 | $1.04 | $2.08 | $2.08
M5 thermal insert | 6 | https://www.mcmaster.com/#94180a361/=14uusj0 | $0.23 | $1.37 | $1.37
M3 thermal insert | 18 | https://www.mcmaster.com/#94180a331/=14uustr | $0.12 | $2.21 | $2.21
608zz bearing | 6 | https://www.lulzbot.com/store/parts/sealed-608-bearing-x4 | $1.25 | $7.50 | $6.38
Extruder spring | 4 | https://www.lulzbot.com/store/parts/spring-6-pack-6mm-od-97mm-fl | $0.58 | $2.33 | $2.33
M3x12 SCHS | 19 | https://www.mcmaster.com/#91502a105/=19jfckc | $0.11 | $2.08 | $2.08
M3x25 SCHS | 4 | https://www.mcmaster.com/#91502a110/=19jfcvs | $0.16 | $0.62 | $0.62
M5 x 12 FHCS | 4 | https://www.mcmaster.com/#91304a123/=19jfeka | $0.18 | $0.73 | $0.73
M4x55 SCHS | 4 | https://www.mcmaster.com/#91292A268 | $0.33 | $1.34 | $1.34
M3 washer | 9 | https://www.mcmaster.com/#90965a130/=19jfewx | $0.03 | $0.24 | $0.24
M4 washer | 8 | https://www.mcmaster.com/#90965a150/=19jff43 | $0.03 | $0.27 | $0.27
M3 grub screw | 2 | https://www.mcmaster.com/#92015a105/=19jffg5 | $0.17 | $0.34 | $0.34
M3 nut | 4 | https://www.mcmaster.com/#91828a211/=19jfgal | $0.06 | $0.22 | $0.22
M4 nut | 8 | https://www.mcmaster.com/#91828a231/=19jfh1b | $0.06 | $0.52 | $0.52
M4x25 SCHS | 4 | https://www.mcmaster.com/#91502a130/=19jfgoh | $0.13 | $0.53 | $0.53
M3x16 FHCS | 4 | https://www.mcmaster.com/#91304a104/=19jfds9 | $0.23 | $0.92 | $0.92
24ga red wire (mm) | 200 | http://www.digikey.com/product-detail/en/alpha-wire/892419-RD005/892419-RD005-ND/5018087 | $0.00 | $0.18 | $0.18
24ga black wire (mm) | 200 | http://www.digikey.com/product-detail/en/alpha-wire/892419-BK005/892419-BK005-ND/5018007 | $0.00 | $0.18 | $0.18
solder sleeve | 12 | https://www.digikey.com/products/en?keywords=A104858-ND | $0.61 | $7.28 | $7.28
panduit (mm) | 1200 | https://www.mcmaster.com/#7840k212/=14uv7by | $0.00 | $3.10 | $3.10
14 POS cir. Connector | 1 | https://www.digikey.com/products/en/connectors-interconnects/circular-connectors-housings/320?k=A1358-ND | $5.44 | $5.44 | $5.44
14POS connector strain relief | 1 | https://www.digikey.com/product-detail/en/te-connectivity-amp-connectors/206070-8/A32516-ND/1014907 | $6.04 | $6.04 | $6.04
 |  |  | Single qty BOM cost | $271.67 | $261.55
 |  |  | Single Qty BOM with printed parts | $321.38 | $311.26

Sheet: printed parts
Copyright 2017 by the Colorado Printing Project, ltd. CC-BY-SA 4.0
Part Name | $ EA | $ Total | Qty | Mass (g) | Mass total (g) | Print time (min) | Print time total (min) | Person time (min) | Person time total (min) | g/hr | $/g | Nozzle Size
 |  |  |  |  |  |  |  |  |  |  |  | 0.5mm | 0.8mm
Twoolhead mount | $4.14 | $4.14 | 1 | 44 | 44 | 55 | 55 | 5 | 5 | 48 | $0.09 |  | x
extruder mount | $3.30 | $6.61 | 2 | 32 | 64 | 38 | 75 | 5 | 10 | 102 | $0.10 |  | x
extruder body | $5.24 | $10.48 | 2 | 48 | 96 | 72 | 144 | 7.5 | 15 | 80 | $0.11 | x
extruder fan | $2.58 | $5.15 | 2 | 14 | 28 | 40 | 80 | 5 | 10 | 42 | $0.18 | x
heatsink fan brace | $3.69 | $7.37 | 2 | 31 | 62 | 61 | 122 | 5 | 10 | 61 | $0.12 |  | x
switch hittermabob | $0.64 | $0.64 | 1 | 4 | 4 | 12 | 12 | 1 | 1 | 22 | $0.15 | x
Small HBG | $1.68 | $3.35 | 2 | 4 | 8 | 14 | 28 | 5 | 10 | 34 | $0.42 | x
Large HBG | $3.24 | $6.47 | 2 | 26 | 52 | 48 | 96 | 5 | 10 | 65 | $0.12 | x
Extruder idler | $1.27 | $2.55 | 2 | 11.2 | 22.4 | 30 | 60 | 1 | 2 | 45 | $0.11 | x
Extruder latch | $0.50 | $1.00 | 2 | 2.6 | 5.2 | 7.5 | 15 | 1 | 2 | 42 | $0.19 | x
Right side wiper mount | $1.46 | $1.46 | 1 | 18 | 18 | 24 | 24 | 1 | 1 | 45 | $0.08 | x
Upper Brace | $0.49 | $0.49 | 1 | 3 | 3 | 9 | 9 | 0.8 | 0.8 | 21 | $0.16 | x
 |  |  |  |  |  |  |  |  |  |  | Average $/g
Total |  | $49.71 | 20 | 238 | 407 | 409 | 719 | 42 | 77 |  | combined | 0.5mm | 0.8mm
Average | $2.35 |  | 1.7 | 20 | 34 | 34 | 60 | 4 | 6 | 51 | $0.15 | $0.17 | $0.11
 |  |  |  |  |  |  |  |  |  |  |  | Average g/hr
 |  |  |  |  |  |  |  |  |  |  |  | 44.0 | 70.5
Labor & equipment costs |  |  | Overhead cost per twoolhead | % of total cost
Printer flip rate per hr | $15.00 |  | $19.21 | 38.64% |  |  |  |  | 0.5 | 44
Printer cost per hr | $0.95 |  | $11.39 | 22.91% |  |  |  |  | 0.8 | 70
Space cost per hr | $0.10 |  | $1.20 | 2.41%
Electricity cost per hr | $0.04 |  | $0.44 | 0.88%
Filament cost (ABS) | $42.95 |  | $17.47 | 35.15%
 |  |  | Total printed part cost per twoolhead |  |  |  | Total print hours per twoolhead
 |  |  | $49.71 |  |  |  | 11.99

Sheet: funding_calculator
Copyright 2017 by the Colorado Printing Project, ltd. CC-BY-SA 4.0
Twoolhead funding goal calculator
Batch Qty | 5
BOM | $311.26
Labor | $45.00
Batch Cost (inc labor) | $1,781.28
Batch Shipping (from mfr) | $50.00
Batch Subtotal | $2,192.53
Freight on board cost | $438.51
Fulfilment fee (pkg + storage) | $5.00
Est. freight to customer | $25.00
Total COGS less CC + CS fees | $2,342.53
Credit card fee (2.9%+$0.30) | $69.43
CrowdSupply fee (10%) | $234.25
Total COGS | $2,646.22
Total COGS/twoolhead | $529.24
Non MOQ COGS | $90.74
Campaign price | $600.00
Min # units | 5
Funding goal without cushion | $3,000.00
Funding goal with cushion | $3,450.00

Sheet: printed parts using single printhead
Copyright 2017 by the Colorado Printing Project, ltd. CC-BY-SA 4.0
Part Name | $ EA | $ Total | Qty | Mass (g) | Mass total (g) | Print time (min) | Print time total (min) | Person time (min) | Person time total (min) | g/hr | $/g | Nozzle Size
 |  |  |  |  |  |  |  |  |  |  |  | 0.5mm | 0.8mm
Twoolhead mount | $4.92 | $4.92 | 1 | 44 | 44 | 110 | 110 | 5 | 5 | 24 | $0.11 |  | x
extruder mount | $3.84 | $7.67 | 2 | 32 | 64 | 75 | 150 | 5 | 10 | 51 | $0.12 |  | x
extruder body | $6.26 | $12.53 | 2 | 48 | 96 | 144 | 288 | 7.5 | 15 | 40 | $0.13 | x
extruder fan | $3.14 | $6.29 | 2 | 14 | 28 | 80 | 160 | 5 | 10 | 21 | $0.22 | x
heatsink fan brace | $4.55 | $9.11 | 2 | 31 | 62 | 122 | 244 | 5 | 10 | 30 | $0.15 |  | x
switch hittermabob | $0.81 | $0.81 | 1 | 4 | 4 | 23 | 23 | 1 | 1 | 11 | $0.19 | x
Small HBG | $1.87 | $3.75 | 2 | 4 | 8 | 28 | 56 | 5 | 10 | 17 | $0.47 | x
Large HBG | $3.92 | $7.84 | 2 | 26 | 52 | 96 | 192 | 5 | 10 | 33 | $0.15 | x
Extruder idler | $1.70 | $3.40 | 2 | 11.2 | 22.4 | 60 | 120 | 1 | 2 | 22 | $0.15 | x
Extruder latch | $0.60 | $1.21 | 2 | 2.6 | 5.2 | 15 | 30 | 1 | 2 | 21 | $0.23 | x
Right side wiper mount | $1.80 | $1.80 | 1 | 18 | 18 | 48 | 48 | 1 | 1 | 23 | $0.10 | x
Upper Brace | $0.61 | $0.61 | 1 | 3 | 3 | 17 | 17 | 0.8 | 0.8 | 11 | $0.20 | x
 |  |  |  |  |  |  |  |  |  |  | Average $/g
Total |  | $59.93 | 20 | 238 | 407 | 818 | 1,438 | 42 | 77 |  | combined | 0.5mm | 0.8mm
Average | $2.84 |  | 1.7 | 20 | 34 | 68 | 120 | 4 | 6 | 25 | $0.19 | $0.21 | $0.13
 |  |  |  |  |  |  |  |  |  |  |  | Average g/hr
 |  |  |  |  |  |  |  |  |  |  |  | 22.0 | 35.2
Labor & equipment costs |  |  | Overhead cost per twoolhead | % of total cost
Printer flip rate per hr | $15.00 |  | $19.21 | 32.05% |  |  |  |  | 0.5 | 22
Printer cost per hr | $0.83 |  | $19.98 | 33.33% |  |  |  |  | 0.8 | 35
Space cost per hr | $0.10 |  | $2.40 | 4.00%
Electricity cost per hr | $0.04 |  | $0.88 | 1.47%
Filament cost (ABS) | $42.95 |  | $17.47 | 29.16%
 |  |  | Total printed part cost per twoolhead |  |  |  | Total print hours per twoolhead
 |  |  | $59.93 |  |  |  | 23.97
