coloradoprintingproject/twoolhead/production_parts/custom_parts/extrusion_fan_with_cutout.stl

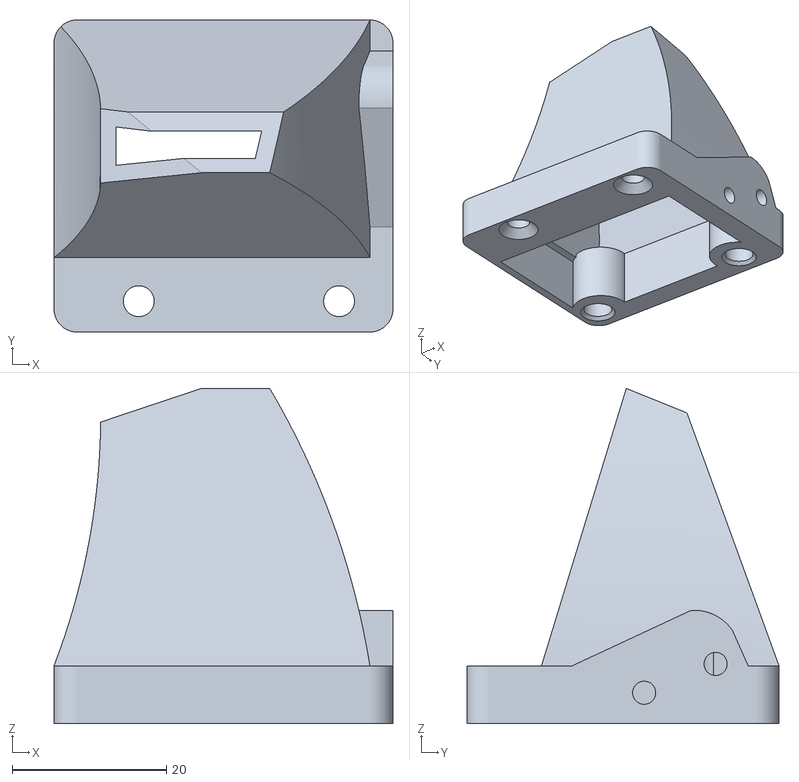
[picture p46: CAD file, 2018-05-16]
production_parts/custom_parts/extrusion_fan_with_cutout.stl
44.0 x 40.5 x 43.5
