coloradoprintingproject/twoolhead/production_parts/custom_parts/FreeCAD_blend/right_side_wiper_mount.fcstd

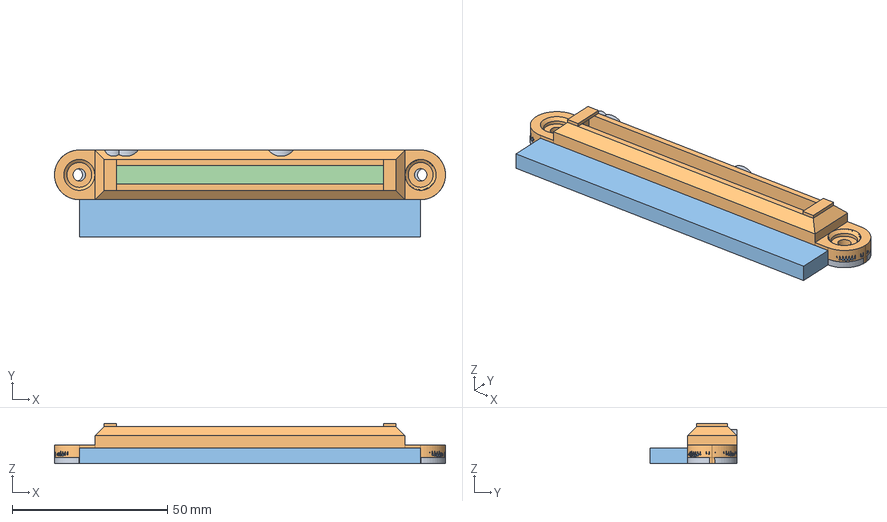
[picture p47: CAD file, 2018-05-16]
production_parts/custom_parts/FreeCAD_blend/right_side_wiper_mount.fcstd
126.0 x 28.0 x 13.0 mm
Pocket004Body
Chamfer001Body
Fillet002Body
