coloradoprintingproject/twoolhead/production_parts/custom_parts/FreeCAD_blend/x_min_switch_hitter_thing.FCStd

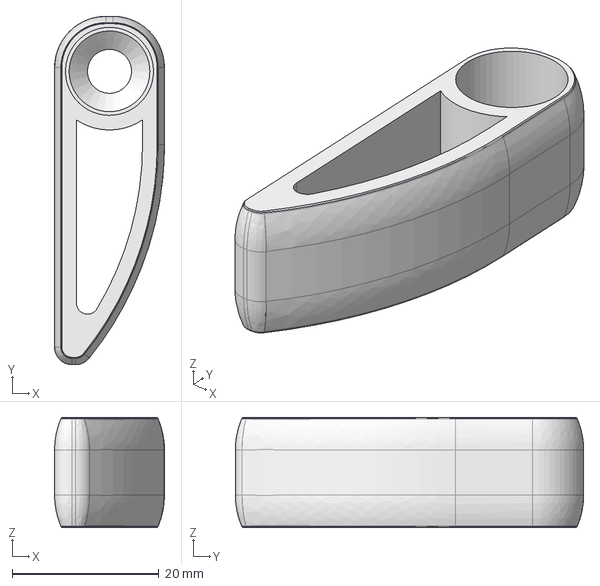
[picture p48: CAD file, 2018-01-04]
production_parts/custom_parts/FreeCAD_blend/x_min_switch_hitter_thing.FCStd
15.0 x 47.5 x 15.0 mm
