coloradoprintingproject/twoolhead/production_parts/custom_parts/right_side_wiper_mount.stl

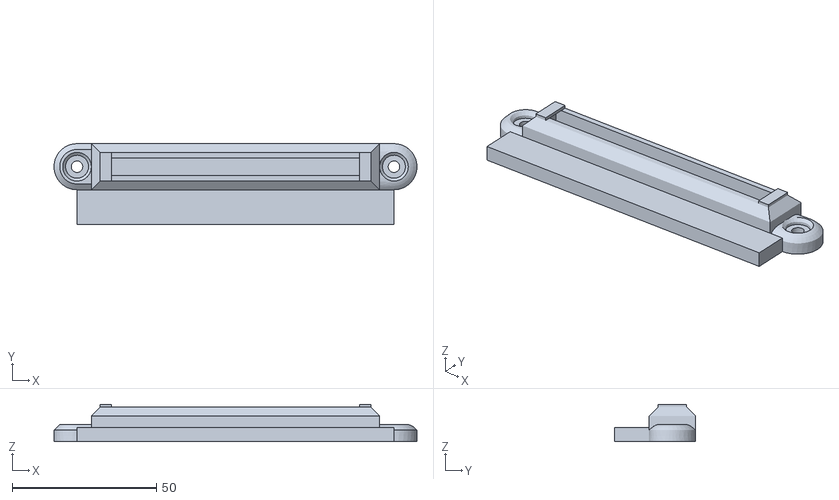
[picture p49: CAD file, 2018-05-16]
production_parts/custom_parts/right_side_wiper_mount.stl
126.0 x 28.0 x 13.0
