coloradoprintingproject/twoolhead/production_parts/custom_parts/FreeCAD_blend/cross_extruder_brace.fcstd

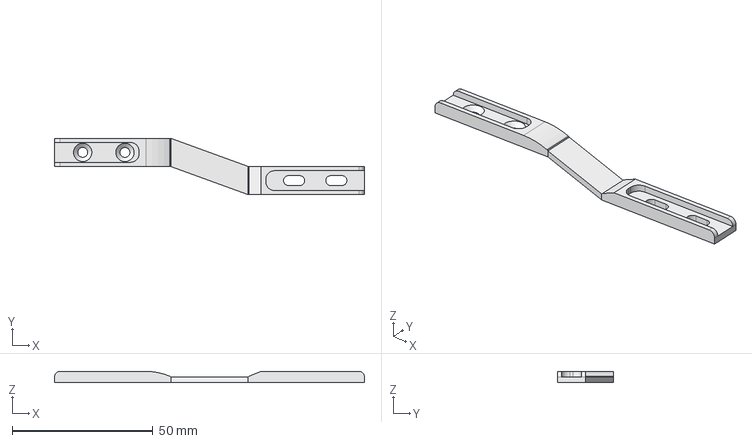
[picture p50: CAD file, 2017-10-18]
production_parts/custom_parts/FreeCAD_blend/cross_extruder_brace.fcstd
110.0 x 20.0 x 4.00 mm
