coloradoprintingproject/twoolhead/production_parts/custom_parts/longblock-mount.stl

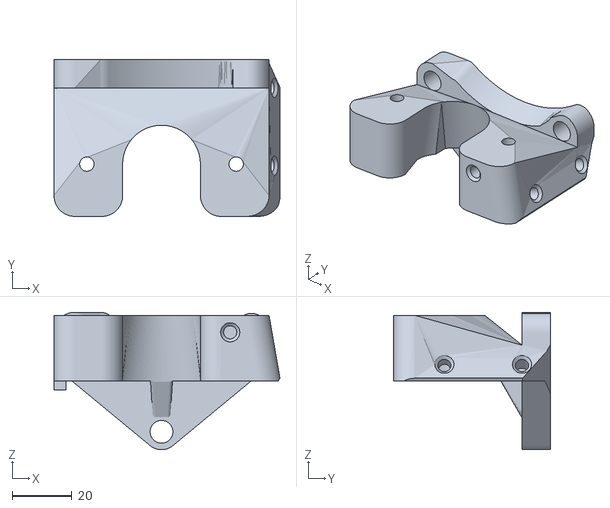
[picture p51: CAD file, 2018-05-15]
production_parts/custom_parts/longblock-mount.stl
75.7 x 52.5 x 46.0
