coloradoprintingproject/twoolhead/production_parts/ao_parts/beefy_idler_latch_v2.2.stl

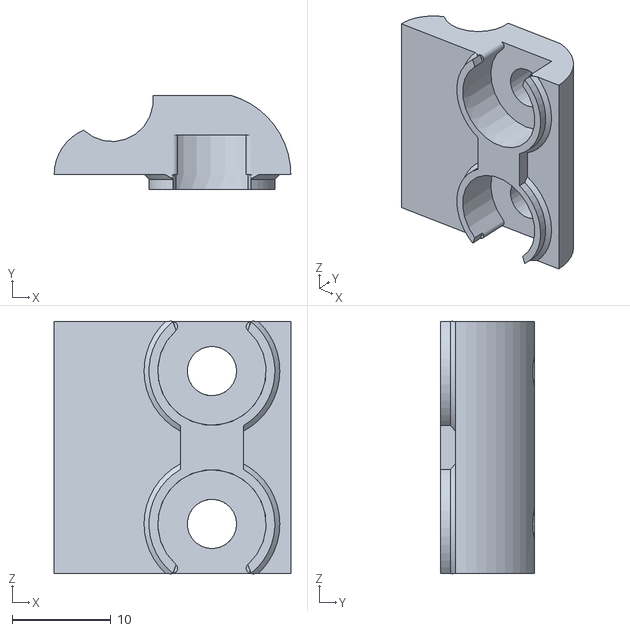
[picture p52: CAD file, 2017-10-18]
production_parts/ao_parts/beefy_idler_latch_v2.2.stl
24.0 x 9.50 x 25.7
