coloradoprintingproject/twoolhead/production_parts/custom_parts/FreeCAD_blend/heatsink_fan_duct_brace_for_bool.stl

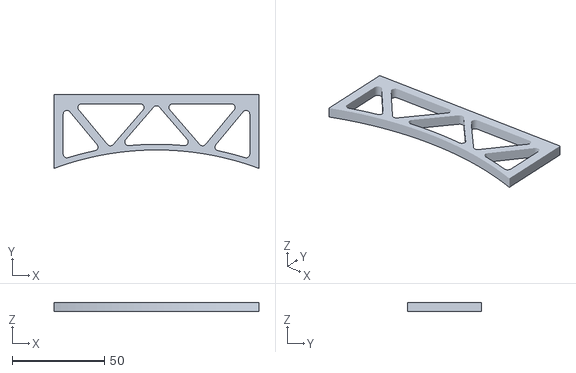
[picture p53: CAD file, 2017-07-27]
production_parts/custom_parts/FreeCAD_blend/heatsink_fan_duct_brace_for_bool.stl
111.0 x 40.0 x 5.00
