coloradoprintingproject/twoolhead/production_parts/ao_parts/opah_extruder_body_v0.2.stl

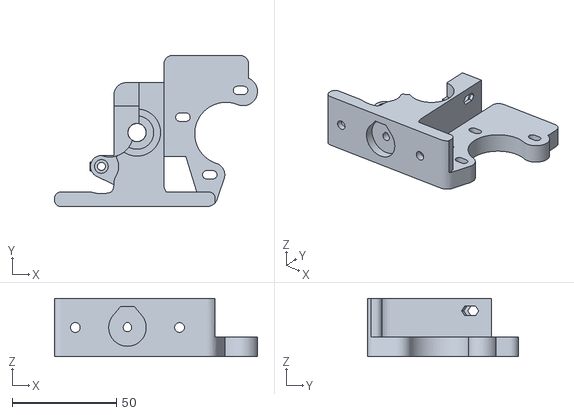
[picture p55: CAD file, 2017-10-18]
production_parts/ao_parts/opah_extruder_body_v0.2.stl
97.4 x 72.5 x 28.0
