coloradoprintingproject/twoolhead/production_parts/custom_parts/slotty_heatsink_fan_brace_0.5mm.stl

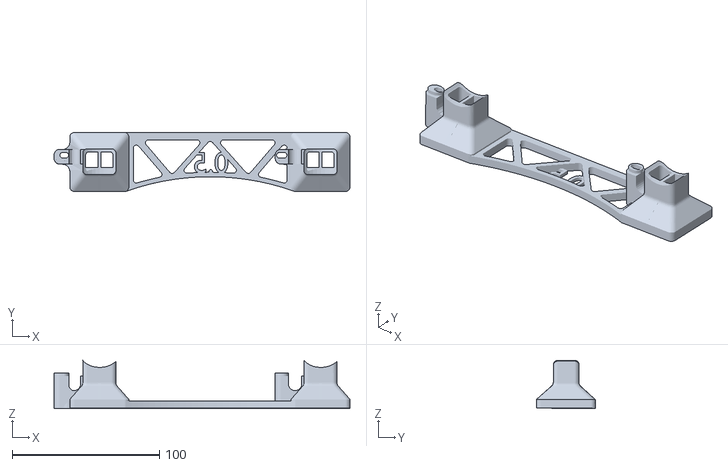
[picture p57: CAD file, 2018-05-15]
production_parts/custom_parts/slotty_heatsink_fan_brace_0.5mm.stl
200.8 x 40.0 x 32.6
