coloradoprintingproject/twoolhead/production_parts/ao_parts/beefy_extruder_idler_v0.4.stl

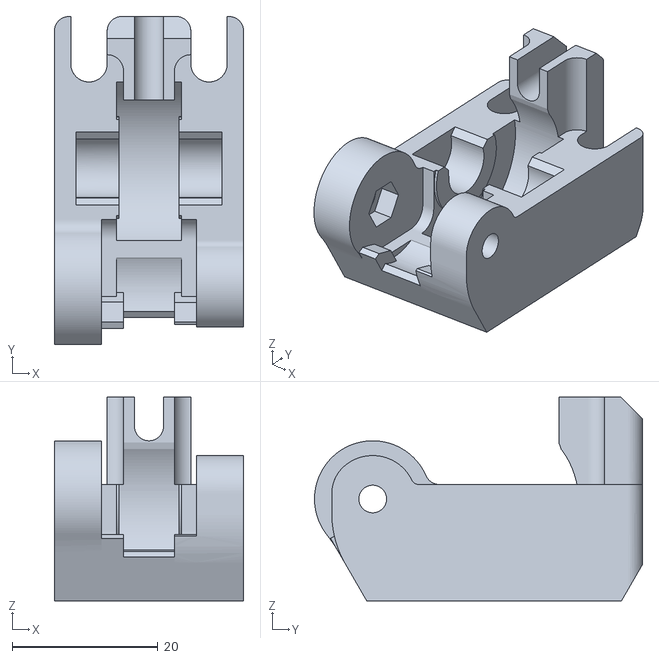
[picture p58: CAD file, 2017-10-18]
production_parts/ao_parts/beefy_extruder_idler_v0.4.stl
26.0 x 45.1 x 28.0
