coloradoprintingproject/twoolhead/production_parts/ao_parts/608zz_bearing.fcstd

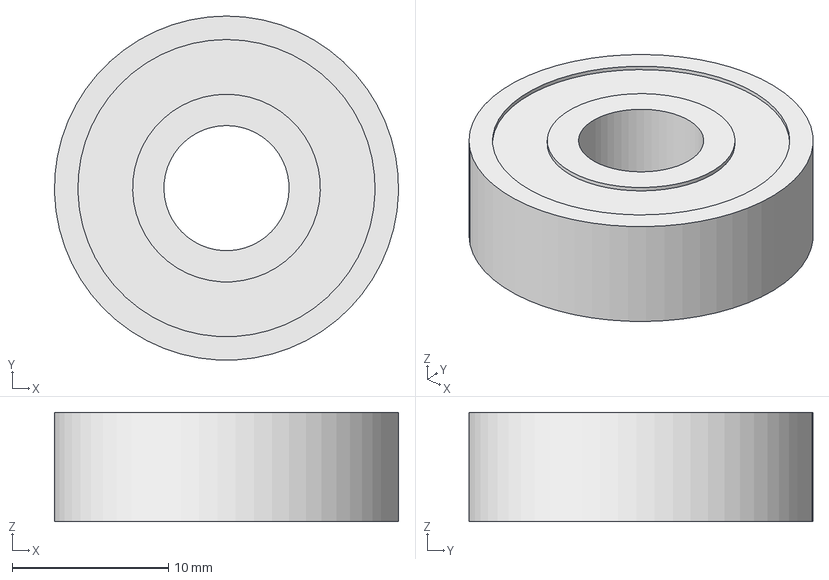
[picture p59: CAD file, 2017-10-18]
production_parts/ao_parts/608zz_bearing.fcstd
22.0 x 22.0 x 7.00 mm
