coloradoprintingproject/twoolhead/production_parts/ao_parts/herringbone_small_gear-1.1-highres.stl

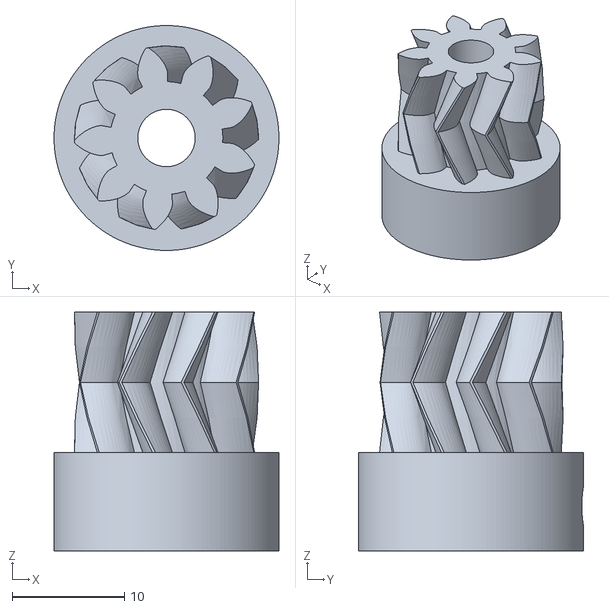
[picture p60: CAD file, 2017-10-18]
production_parts/ao_parts/herringbone_small_gear-1.1-highres.stl
20.0 x 20.0 x 21.2
