coloradoprintingproject/twoolhead/production_parts/custom_parts/upper_extruder_brace.stl

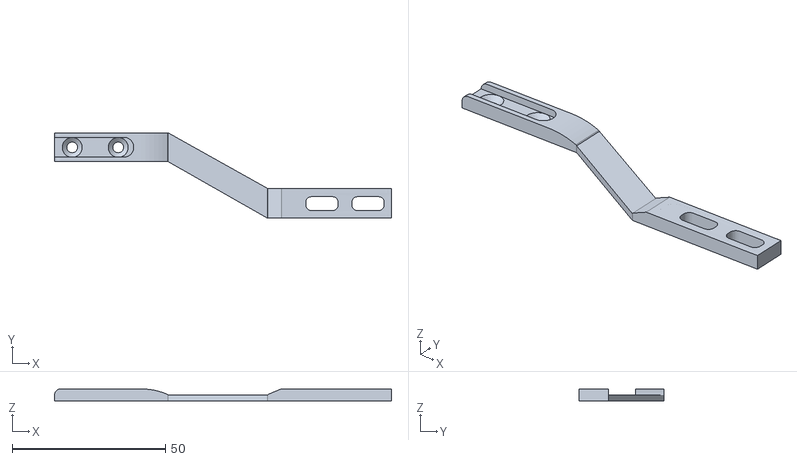
[picture p61: CAD file, 2017-12-18]
production_parts/custom_parts/upper_extruder_brace.stl
109.8 x 27.8 x 4.03
