coloradoprintingproject/twoolhead/production_parts/ao_parts/40mm_Fan_grill_final.stl

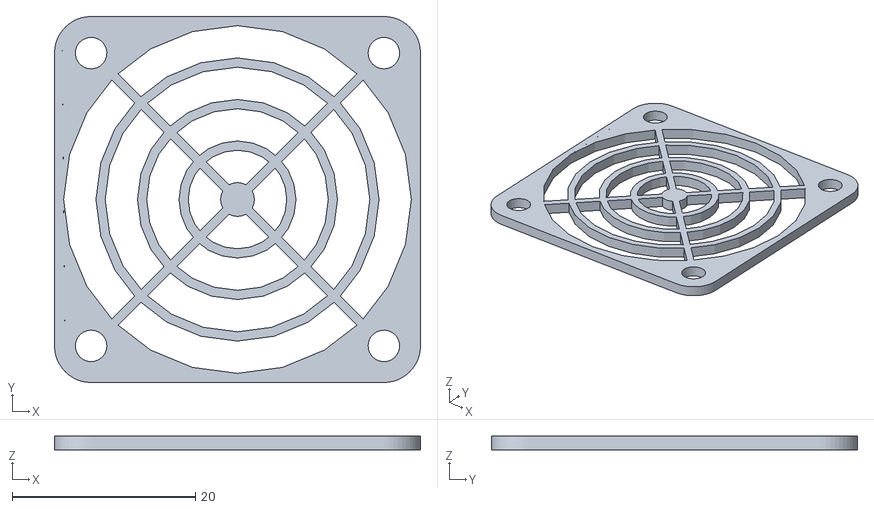
[picture p62: CAD file, 2017-10-18]
production_parts/ao_parts/40mm_Fan_grill_final.stl
40.0 x 40.0 x 1.50
