coloradoprintingproject/twoolhead/production_parts/ao_parts/lrg_herringbone_gear_v1.3.stl

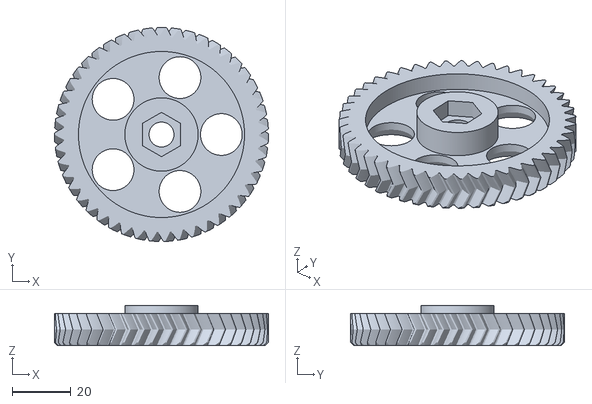
[picture p63: CAD file, 2017-10-18]
production_parts/ao_parts/lrg_herringbone_gear_v1.3.stl
73.0 x 73.0 x 13.8
