coloradoprintingproject/twoolhead/production_parts/custom_parts/stilty-extruder-mount.stl

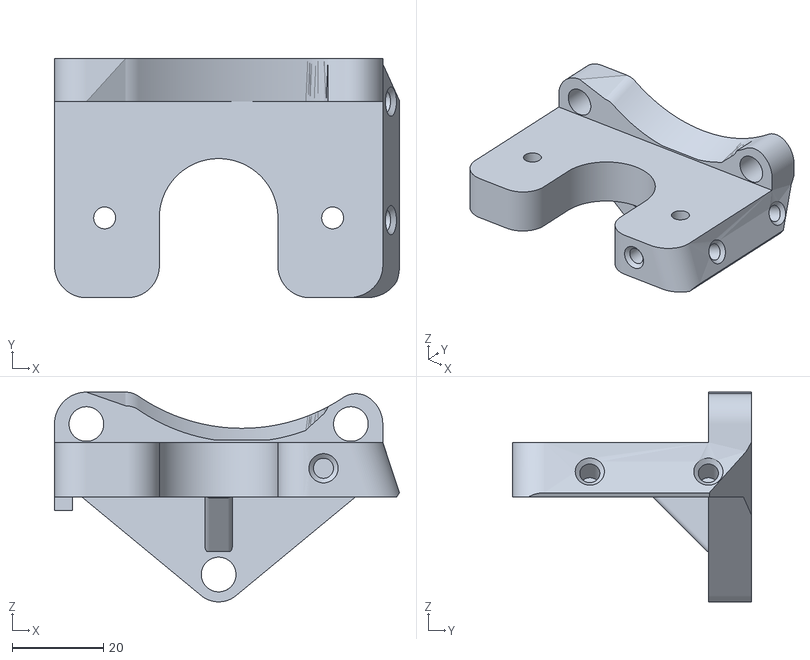
[picture p64: CAD file, 2017-11-20]
production_parts/custom_parts/stilty-extruder-mount.stl
75.7 x 52.5 x 46.0
