coloradoprintingproject/twoolhead/production_parts/ao_parts/Motor_NEMA17.stl

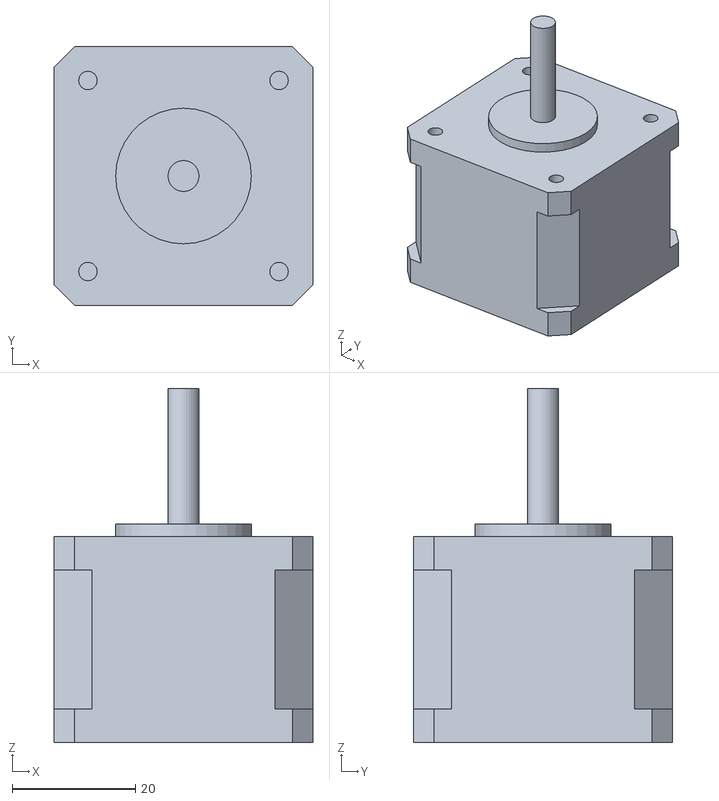
[picture p65: CAD file, 2017-10-18]
production_parts/ao_parts/Motor_NEMA17.stl
42.0 x 42.0 x 57.4
