coloradoprintingproject/twoolhead/production_parts/custom_parts/twoolhead_back_plate.stl

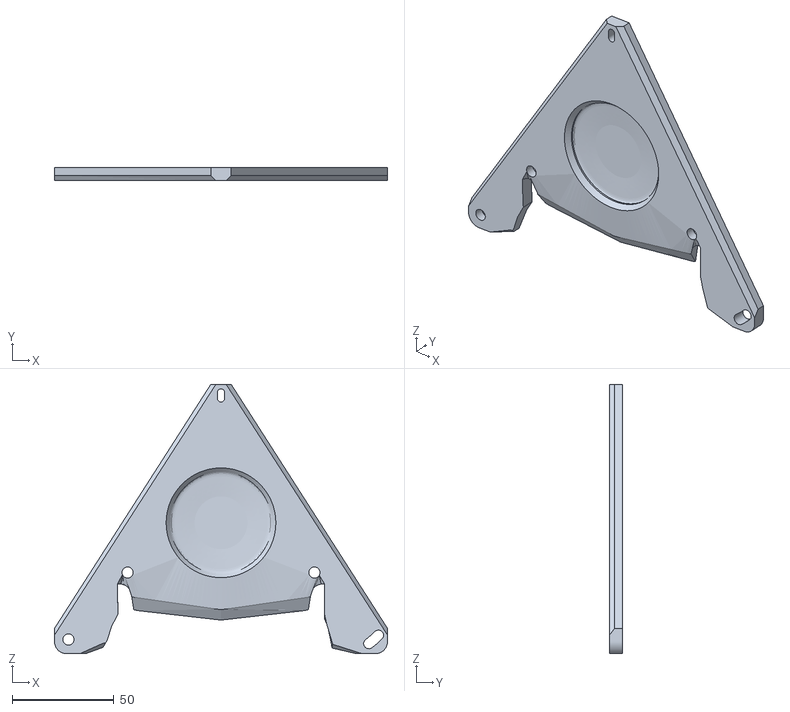
[picture p66: CAD file, 2017-10-18]
production_parts/custom_parts/twoolhead_back_plate.stl
164.0 x 6.47 x 132.7
