coloradoprintingproject/twoolhead/(list of files, cad)

Other CAD files:
production_parts/custom_parts/FreeCAD_blend/heatsink_fan_duct_brace_for_bool_v0.1.FCStd
production_parts/ao_parts/extruder_fan_mount_v2.1_mini.stl
production_parts/custom_parts/slotty_heatsink_fan_brace_1.2mm.stl
production_parts/custom_parts/x_min_switch_hitter_thing.stl
production_parts/custom_parts/slotty_heatsink_fan_brace.stl
production_parts/ao_parts/608zz_bearing.stl
production_parts/ao_parts/extruder_washer_v3.0-x16.stl
production_parts/ao_parts/hobbed_bolt_mockup.fcstd
production_parts/ao_parts/hobbed_bolt_mockup.stl
production_parts/ao_parts/jonaskuehling_gregs-wade-ao-v3-washer-x7.stl
production_parts/custom_parts/FreeCAD_blend/stilty-extruder-mount.blend
production_parts/custom_parts/heatsink_brace.blend
production_parts/custom_parts/longblock-mount.blend
