coloradoprintingproject/twoolhead/print_profiles/print_profile_docs/twoolhead_start_gcodes.odt

HT

;This profile is designed specifically for LulzBot TAZ 6 3D Printer with a Twoolhead

;Basic slice data:

;Sliced at: {day} {date} {time}

;Layer height: {layer_height}

;Walls: {wall_thickness}

;Fill: {fill_density}

;Estimated Print time: {print_time}

;Filament used: {filament_amount}m {filament_weight}g

;Filament cost: {filament_cost}

G26 ; clear potential 'probe fail' condition

G21 ; set units to Millimetres

M107 ; disable fans

G90 ; absolute positioning

M82 ; set extruder to absolute mode

G92 E0 ; set extruder position to 0

M140 S{print_bed_temperature}; get bed heating up

G28 ; home X and Y

T0 ; select extruder 1

M104 S170 ; set to 150C

T1 ; select extruder 2

M109 S170 ; set to 150 and wait

T0 ; select extruder 1

G92 E30 ; set extruder position to 30

G1 E0 F100 ; retract fialment out of the melt zone

G1 X-15 Y100 F3000 ; move above wiper pad

G1 Z0.5 ; push nozzle into wiper

G1 X-17 Y95 F1000 ; slow wipe

G1 X-17 Y90 F1000 ; slow wipe

G1 X-17 Y85 F1000 ; slow wipe

G1 X-15 Y90 F1000 ; slow wipe

G1 X-17 Y80 F1000 ; slow wipe

G1 X-15 Y95 F1000 ; slow wipe

G1 X-17 Y75 F2000 ; fast wipe

G1 X-15 Y65 F2000 ; fast wipe

G1 X-17 Y70 F2000 ; fast wipe

G1 X-15 Y60 F2000 ; fast wipe

G1 X-17 Y55 F2000 ; fast wipe

G1 X-15 Y50 F2000 ; fast wipe

G1 X-17 Y40 F2000 ; fast wipe

G1 X-15 Y45 F2000 ; fast wipe

G1 X-17 Y35 F2000 ; fast wipe

G1 X-15 Y40 F2000 ; fast wipe

G1 X-17 Y70 F2000 ; fast wipe

G1 X-15 Y30 Z2 F2000 ; fast wipe

G1 X-17 Y35 F2000 ; fast wipe

G1 X-15 Y25 F2000 ; fast wipe

G1 X-17 Y30 F2000 ; fast wipe

G1 X-15 Y25 Z1.5 F1000 ; slow wipe

G1 X-17 Y23 F1000 ; slow wipe

G1 Z10 ; raise extruder

G1 X155 Y95 F3000 ; move above other wiper

G1 Z0.5 ; move down into wiper pad

G1 X155 Y90 F1000 ; slow wipe

G1 X155 Y85 F1000 ; slow wipe

G1 X153 Y90 F1000 ; slow wipe

G1 X155 Y80 F1000 ; slow wipe

G1 X153 Y95 F1000 ; slow wipe

G1 X155 Y75 F2000 ; fast wipe

G1 X153 Y65 F2000 ; fast wipe

G1 X155 Y70 F2000 ; fast wipe

G1 X153 Y60 F2000 ; fast wipe

G1 X155 Y55 F2000 ; fast wipe

G1 X153 Y50 F2000 ; fast wipe

G1 X155 Y40 F2000 ; fast wipe

G1 X153 Y45 F2000 ; fast wipe

G1 X155 Y35 F2000 ; fast wipe

G1 X153 Y40 F2000 ; fast wipe

G1 X155 Y70 F2000 ; fast wipe

G1 X153 Y30 F2000 ; fast wipe

G1 X155 Y35 F2000 ; fast wipe

G1 X153 Y25 F2000 ; fast wipe

G1 X155 Y30 F2000 ; fast wipe

G1 X153 Y25 F1000 ; slow wipe

G1 X155 Y23 F1000 ; slow wipe

G1 Z10 ; raise extruder

M204 S100 ; set accel for probing

G29 ; probe sequence (for auto-leveling)

M204 S200 ; set accel back to normal

G1 X0 Y0 Z15 F5000 ; get out the way

M400 ; clear buffer

G4 S1 ; pause

M117 Heating... ; LCD status message

M140 S{print_bed_temperature}; get bed heating up

T1

M104 S{print_temperature} ; set extruder temp

T0

M109 R{print_temperature} ; set extruder temp and wait

T1

M109 R{print_temperature} ; set extruder temp and wait

T0

M190 R{print_bed_temperature}; get bed temping up during first layer

G1 Z2 E30 F75 ; extrude filament back into nozzle

G92 E0 ; tare

M117 TAZ Printing... ; LCD status message

PLA

;This profile is designed specifically for LulzBot TAZ 6 3D Printer with a Twoolhead

;Basic slice data:

;Sliced at: {day} {date} {time}

;Layer height: {layer_height}

;Walls: {wall_thickness}

;Fill: {fill_density}

;Estimated Print time: {print_time}

;Filament used: {filament_amount}m {filament_weight}g

;Filament cost: {filament_cost}

G26 ; clear potential 'probe fail' condition

G21 ; set units to Millimetres

M107 ; disable fans

G90 ; absolute positioning

M82 ; set extruder to absolute mode

G92 E0 ; set extruder position to 0

M140 S{print_bed_temperature}; get bed heating up

G28 ; home X and Y

T0 ; select extruder 1

M104 S150 ; set to 150C

T1 ; select extruder 2

M109 S150 ; set to 150 and wait

T0 ; select extruder 1

G92 E30 ; set extruder position to 30

G1 E0 F100 ; retract fialment out of the melt zone

G1 X-15 Y100 F3000 ; move above wiper pad

G1 Z0.5 ; push nozzle into wiper

G1 X-17 Y95 F1000 ; slow wipe

G1 X-17 Y90 F1000 ; slow wipe

G1 X-17 Y85 F1000 ; slow wipe

G1 X-15 Y90 F1000 ; slow wipe

G1 X-17 Y80 F1000 ; slow wipe

G1 X-15 Y95 F1000 ; slow wipe

G1 X-17 Y75 F2000 ; fast wipe

G1 X-15 Y65 F2000 ; fast wipe

G1 X-17 Y70 F2000 ; fast wipe

G1 X-15 Y60 F2000 ; fast wipe

G1 X-17 Y55 F2000 ; fast wipe

G1 X-15 Y50 F2000 ; fast wipe

G1 X-17 Y40 F2000 ; fast wipe

G1 X-15 Y45 F2000 ; fast wipe

G1 X-17 Y35 F2000 ; fast wipe

G1 X-15 Y40 F2000 ; fast wipe

G1 X-17 Y70 F2000 ; fast wipe

G1 X-15 Y30 Z2 F2000 ; fast wipe

G1 X-17 Y35 F2000 ; fast wipe

G1 X-15 Y25 F2000 ; fast wipe

G1 X-17 Y30 F2000 ; fast wipe

G1 X-15 Y25 Z1.5 F1000 ; slow wipe

G1 X-17 Y23 F1000 ; slow wipe

G1 Z10 ; raise extruder

G1 X155 Y95 F3000 ; move above other wiper

G1 Z0.5 ; move down into wiper pad

G1 X155 Y90 F1000 ; slow wipe

G1 X155 Y85 F1000 ; slow wipe

G1 X153 Y90 F1000 ; slow wipe

G1 X155 Y80 F1000 ; slow wipe

G1 X153 Y95 F1000 ; slow wipe

G1 X155 Y75 F2000 ; fast wipe

G1 X153 Y65 F2000 ; fast wipe

G1 X155 Y70 F2000 ; fast wipe

G1 X153 Y60 F2000 ; fast wipe

G1 X155 Y55 F2000 ; fast wipe

G1 X153 Y50 F2000 ; fast wipe

G1 X155 Y40 F2000 ; fast wipe

G1 X153 Y45 F2000 ; fast wipe

G1 X155 Y35 F2000 ; fast wipe

G1 X153 Y40 F2000 ; fast wipe

G1 X155 Y70 F2000 ; fast wipe

G1 X153 Y30 F2000 ; fast wipe

G1 X155 Y35 F2000 ; fast wipe

G1 X153 Y25 F2000 ; fast wipe

G1 X155 Y30 F2000 ; fast wipe

G1 X153 Y25 F1000 ; slow wipe

G1 X155 Y23 F1000 ; slow wipe

G1 Z10 ; raise extruder

M204 S100 ; set accel for probing

G29 ; probe sequence (for auto-leveling)

M204 S200 ; set accel back to normal

G1 X0 Y0 Z15 F5000 ; get out the way

M400 ; clear buffer

G4 S1 ; pause

M117 Heating... ; LCD status message

M140 S{print_bed_temperature}; get bed heating up

T1

M104 S{print_temperature} ; set extruder temp

T0

M109 R{print_temperature} ; set extruder temp and wait

T1

M109 R{print_temperature} ; set extruder temp and wait

T0

M190 R{print_bed_temperature}; get bed temping up during first layer

G1 Z2 E30 F75 ; extrude filament back into nozzle

G92 E0 ; tare

M117 TAZ Printing... ; LCD status message

ABS

;This profile is designed specifically for LulzBot TAZ 6 3D Printer with a Twoolhead

;Basic slice data:

;Sliced at: {day} {date} {time}

;Layer height: {layer_height}

;Walls: {wall_thickness}

;Fill: {fill_density}

;Estimated Print time: {print_time}

;Filament used: {filament_amount}m {filament_weight}g

;Filament cost: {filament_cost}

G26 ; clear potential 'probe fail' condition

G21 ; set units to Millimetres

M107 ; disable fans

G90 ; absolute positioning

M82 ; set extruder to absolute mode

G92 E0 ; set extruder position to 0

M140 S{print_bed_temperature}; get bed heating up

G28 ; home X and Y

T0 ; select extruder 1

M104 S170 ; set to 150C

T1 ; select extruder 2

M109 S170 ; set to 150 and wait

T0 ; select extruder 1

G92 E30 ; set extruder position to 30

G1 E0 F100 ; retract fialment out of the melt zone

G1 X-15 Y100 F3000 ; move above wiper pad

G1 Z0.5 ; push nozzle into wiper

G1 X-17 Y95 F1000 ; slow wipe

G1 X-17 Y90 F1000 ; slow wipe

G1 X-17 Y85 F1000 ; slow wipe

G1 X-15 Y90 F1000 ; slow wipe

G1 X-17 Y80 F1000 ; slow wipe

G1 X-15 Y95 F1000 ; slow wipe

G1 X-17 Y75 F2000 ; fast wipe

G1 X-15 Y65 F2000 ; fast wipe

G1 X-17 Y70 F2000 ; fast wipe

G1 X-15 Y60 F2000 ; fast wipe

G1 X-17 Y55 F2000 ; fast wipe

G1 X-15 Y50 F2000 ; fast wipe

G1 X-17 Y40 F2000 ; fast wipe

G1 X-15 Y45 F2000 ; fast wipe

G1 X-17 Y35 F2000 ; fast wipe

G1 X-15 Y40 F2000 ; fast wipe

G1 X-17 Y70 F2000 ; fast wipe

G1 X-15 Y30 Z2 F2000 ; fast wipe

G1 X-17 Y35 F2000 ; fast wipe

G1 X-15 Y25 F2000 ; fast wipe

G1 X-17 Y30 F2000 ; fast wipe

G1 X-15 Y25 Z1.5 F1000 ; slow wipe

G1 X-17 Y23 F1000 ; slow wipe

G1 Z10 ; raise extruder

G1 X155 Y95 F3000 ; move above other wiper

G1 Z0.5 ; move down into wiper pad

G1 X155 Y90 F1000 ; slow wipe

G1 X155 Y85 F1000 ; slow wipe

G1 X153 Y90 F1000 ; slow wipe

G1 X155 Y80 F1000 ; slow wipe

G1 X153 Y95 F1000 ; slow wipe

G1 X155 Y75 F2000 ; fast wipe

G1 X153 Y65 F2000 ; fast wipe

G1 X155 Y70 F2000 ; fast wipe

G1 X153 Y60 F2000 ; fast wipe

G1 X155 Y55 F2000 ; fast wipe

G1 X153 Y50 F2000 ; fast wipe

G1 X155 Y40 F2000 ; fast wipe

G1 X153 Y45 F2000 ; fast wipe

G1 X155 Y35 F2000 ; fast wipe

G1 X153 Y40 F2000 ; fast wipe

G1 X155 Y70 F2000 ; fast wipe

G1 X153 Y30 F2000 ; fast wipe

G1 X155 Y35 F2000 ; fast wipe

G1 X153 Y25 F2000 ; fast wipe

G1 X155 Y30 F2000 ; fast wipe

G1 X153 Y25 F1000 ; slow wipe

G1 X155 Y23 F1000 ; slow wipe

G1 Z10 ; raise extruder

M204 S100 ; set accel for probing

G29 ; probe sequence (for auto-leveling)

M204 S200 ; set accel back to normal

G1 X0 Y0 Z15 F5000 ; get out the way

M400 ; clear buffer

G4 S1 ; pause

M117 Heating... ; LCD status message

M140 S{print_bed_temperature}; get bed heating up

T1

M104 S{print_temperature} ; set extruder temp

T0

M109 R{print_temperature} ; set extruder temp and wait

T1

M109 R{print_temperature} ; set extruder temp and wait

T0

M190 R{print_bed_temperature}; get bed temping up during first layer

G1 Z2 E30 F75 ; extrude filament back into nozzle

G92 E0 ; tare

M117 TAZ Printing... ; LCD status message
