coloradoprintingproject/twoolhead/media/photo/alpha_prototype_images/printing_cute_rockto_twins.jpg

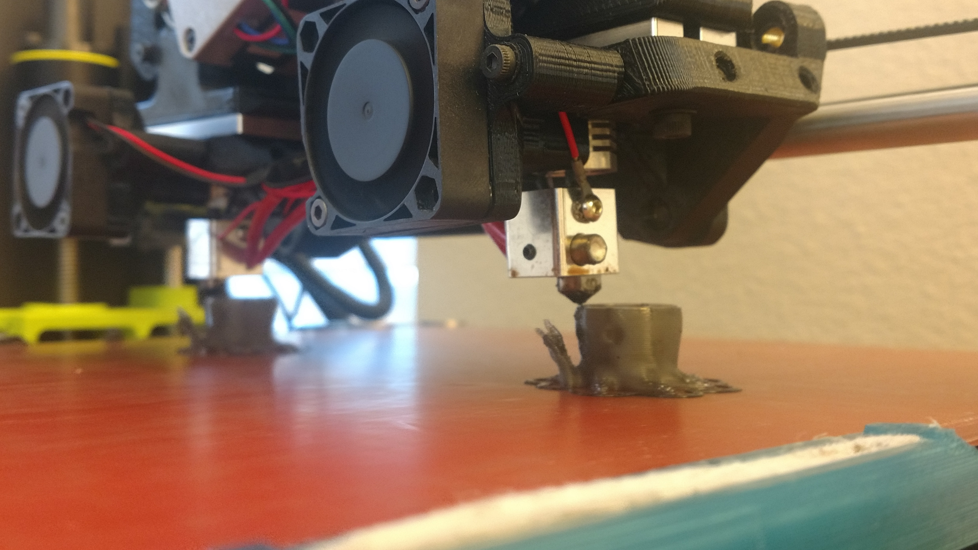
media/photo/alpha_prototype_images/printing_cute_rockto_twins.jpg
