coloradoprintingproject/twoolhead/media/photo/crowdsupply_campaign_images/parallel-printing_vs_injection-molding.png

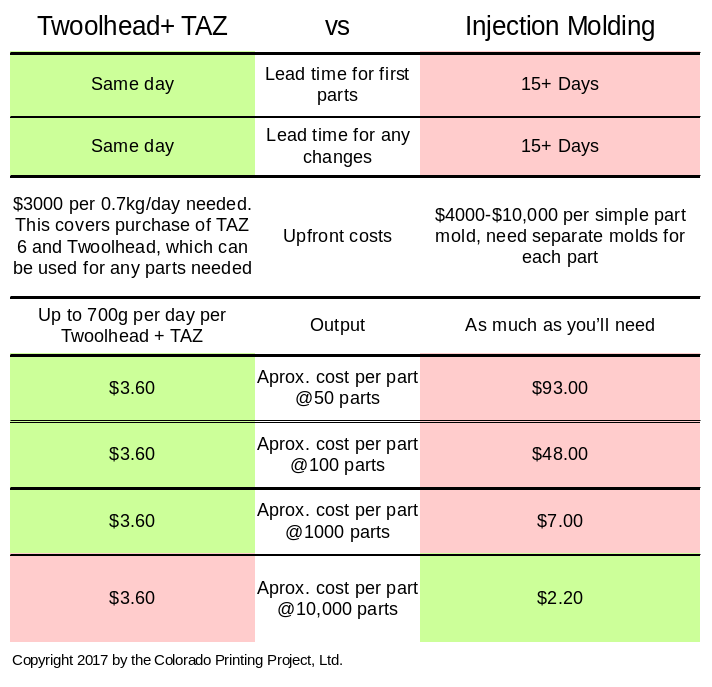
media/photo/crowdsupply_campaign_images/parallel-printing_vs_injection-molding.png
