coloradoprintingproject/twoolhead/media/photo/crowdsupply_campaign_images/twaz-6-printing-brace2.jpg

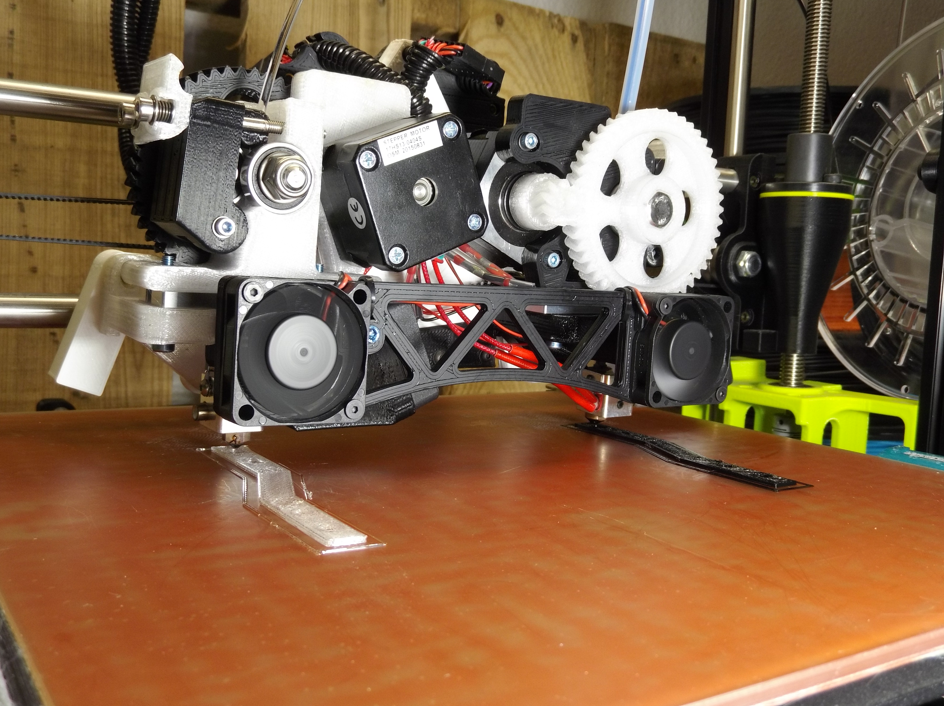
media/photo/crowdsupply_campaign_images/twaz-6-printing-brace2.jpg
