coloradoprintingproject/twoolhead/media/photo/crowdsupply_campaign_images/twaz-6-printing-gears3.jpg

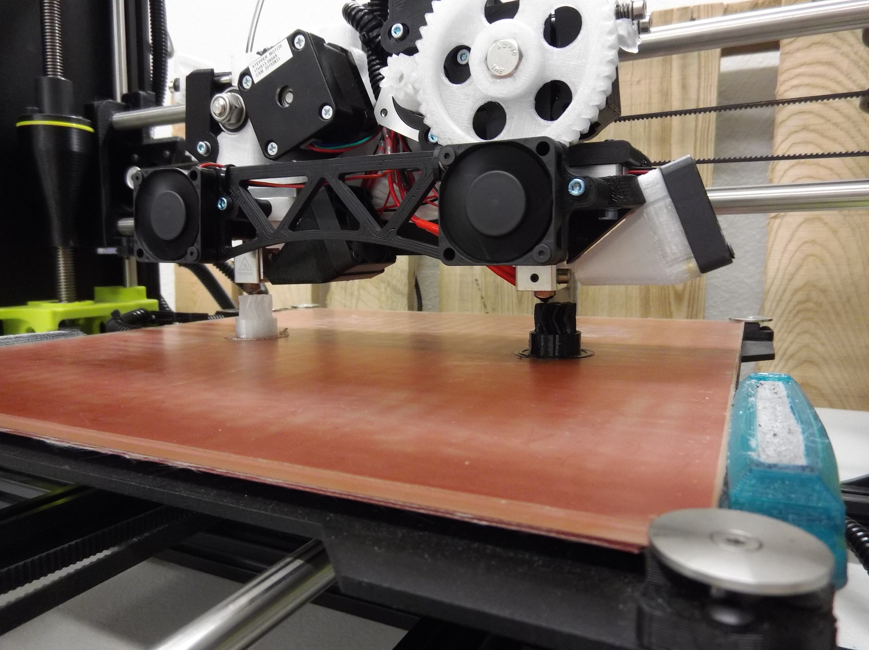
media/photo/crowdsupply_campaign_images/twaz-6-printing-gears3.jpg
