coloradoprintingproject/twoolhead/media/photo/fuzzy-wuzzy-wuz-a-printer.png

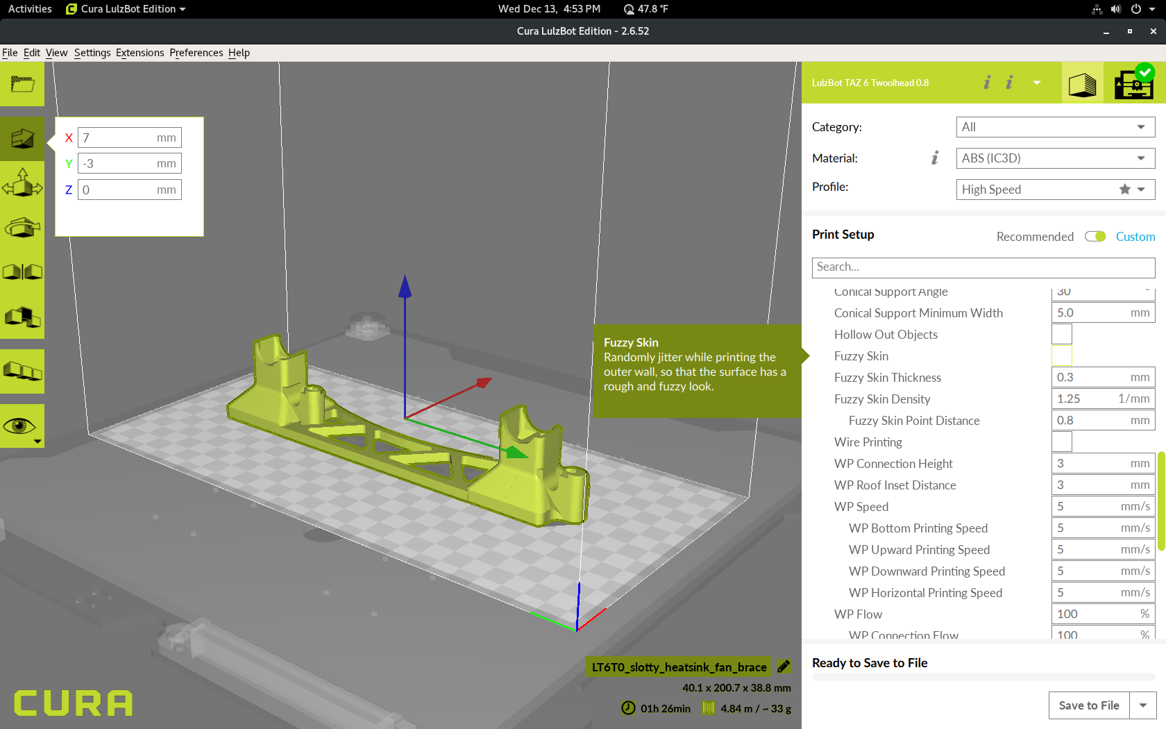
media/photo/fuzzy-wuzzy-wuz-a-printer.png
