coloradoprintingproject/twoolhead/media/photo/setup_guide_photos/IMG_20171006_073352276.jpg

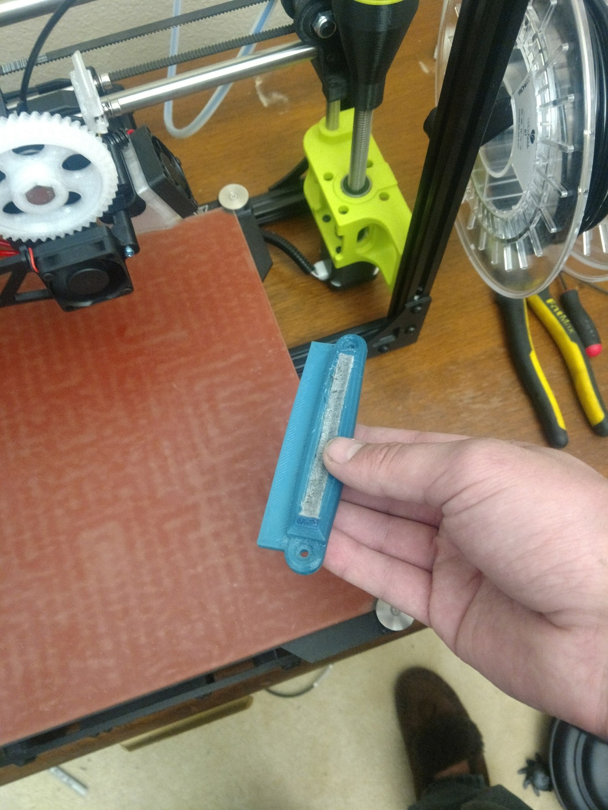
media/photo/setup_guide_photos/IMG_20171006_073352276.jpg
