coloradoprintingproject/twoolhead/media/photo/setup_guide_photos/IMG_20171006_073401746.jpg

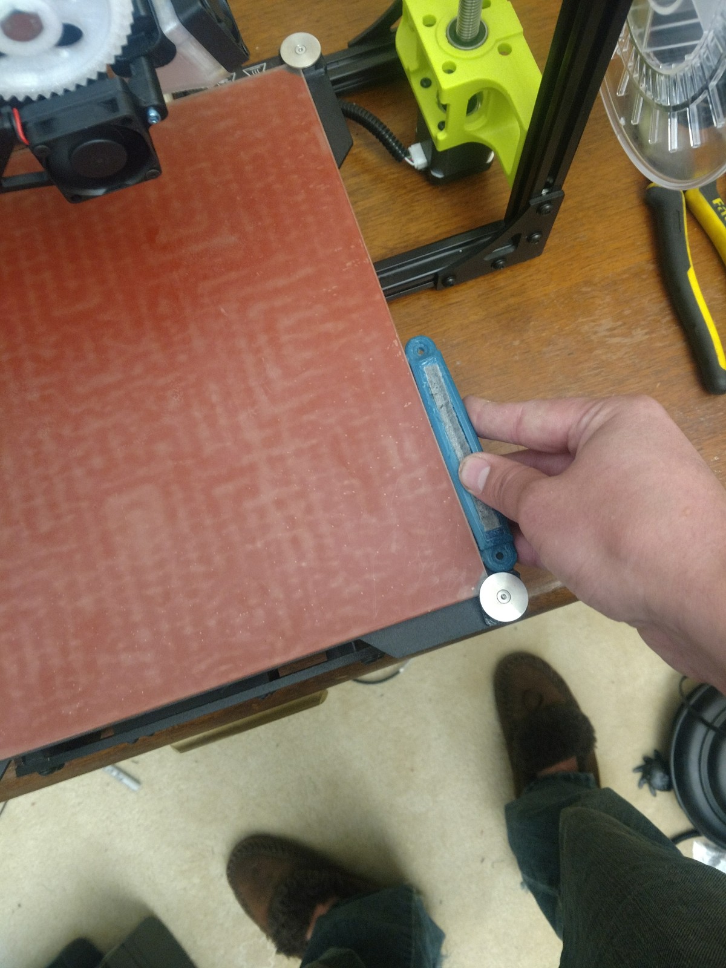
media/photo/setup_guide_photos/IMG_20171006_073401746.jpg
