coloradoprintingproject/twoolhead/media/photo/setup_guide_photos/IMG_20171006_073739428.jpg

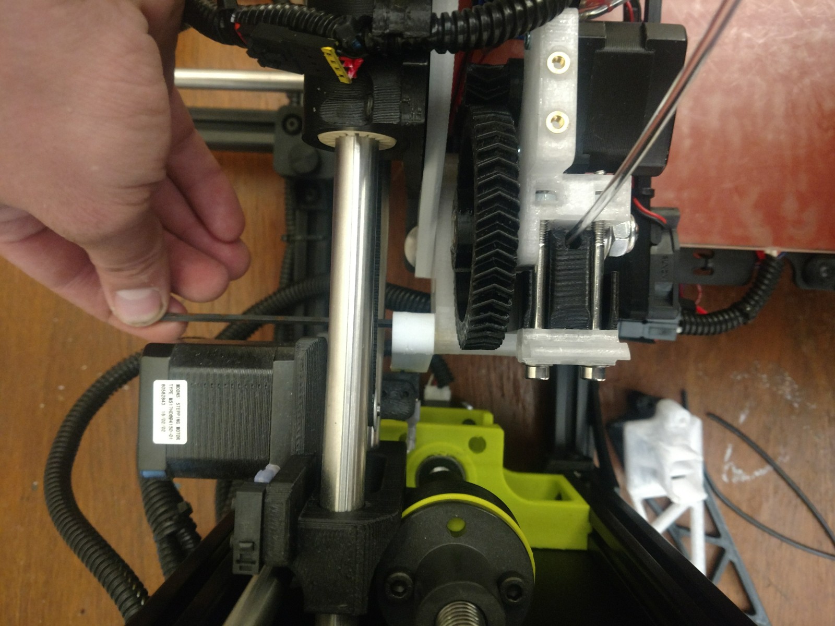
media/photo/setup_guide_photos/IMG_20171006_073739428.jpg
