coloradoprintingproject/twoolhead/media/photo/setup_guide_photos/IMG_20171006_073948995.jpg

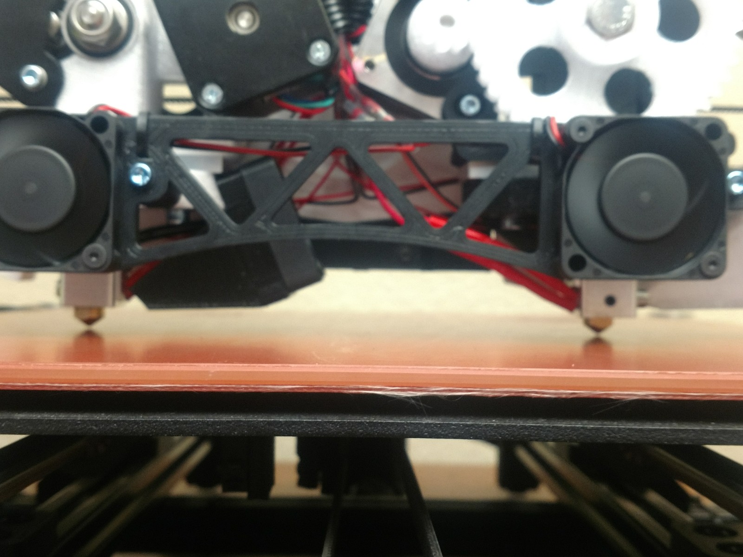
media/photo/setup_guide_photos/IMG_20171006_073948995.jpg
