coloradoprintingproject/twoolhead/media/photo/setup_guide_photos/IMG_20171006_074004527.jpg

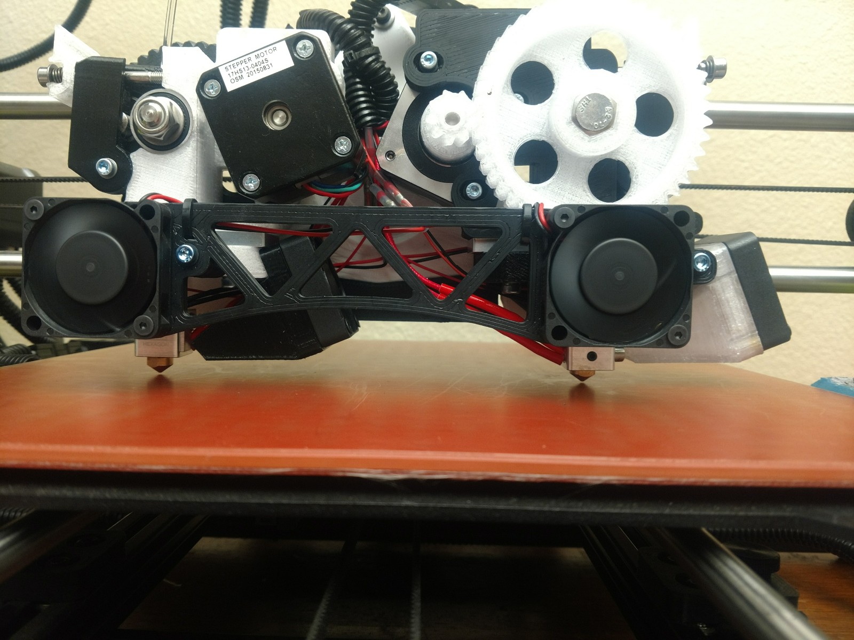
media/photo/setup_guide_photos/IMG_20171006_074004527.jpg
