coloradoprintingproject/twoolhead/media/photo/setup_guide_photos/IMG_20171006_074025771.jpg

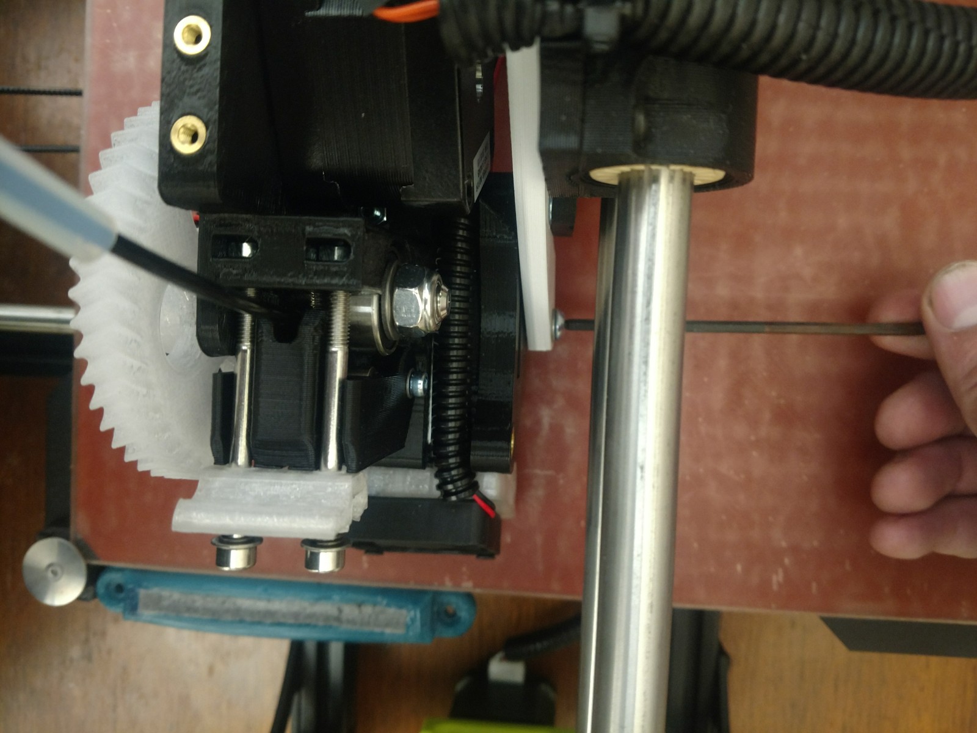
media/photo/setup_guide_photos/IMG_20171006_074025771.jpg
