coloradoprintingproject/twoolhead/media/photo/setup_guide_photos/IMG_20171006_074119223.jpg

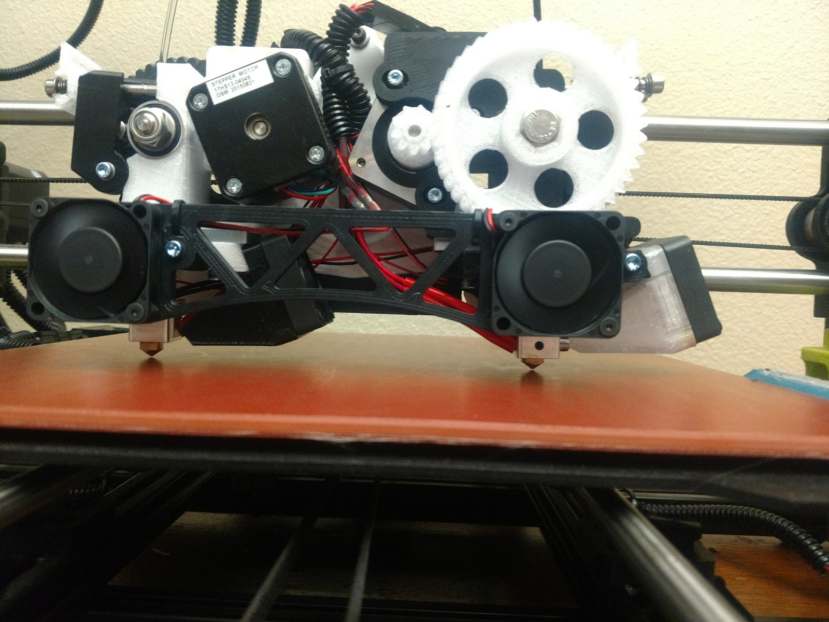
media/photo/setup_guide_photos/IMG_20171006_074119223.jpg
