coloradoprintingproject/twoolhead/media/photo/setup_guide_photos/IMG_20171006_074931335.jpg

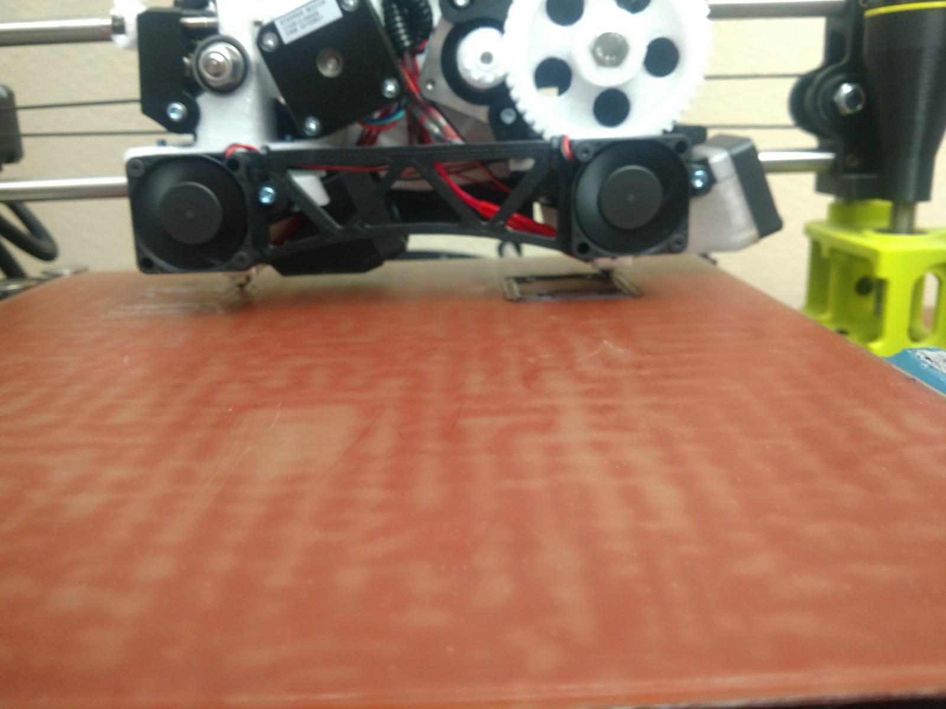
media/photo/setup_guide_photos/IMG_20171006_074931335.jpg
