coloradoprintingproject/twoolhead/media/photo/setup_guide_photos/IMG_20171006_081422923.jpg

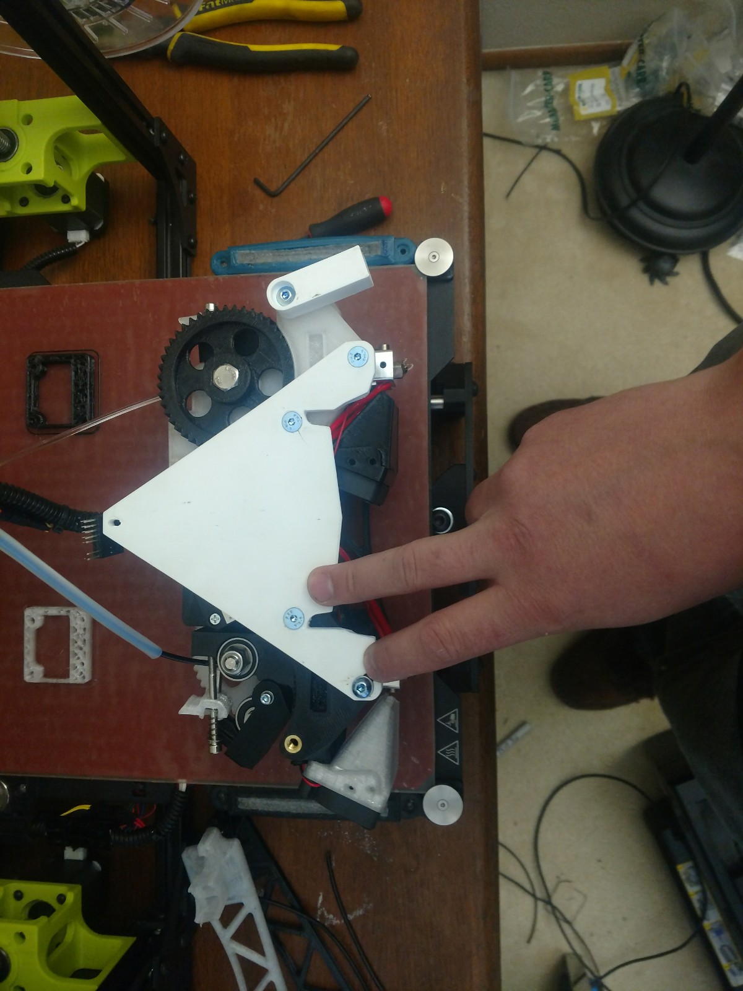
media/photo/setup_guide_photos/IMG_20171006_081422923.jpg
