coloradoprintingproject/twoolhead/media/photo/setup_guide_photos/IMG_20171006_081428340.jpg

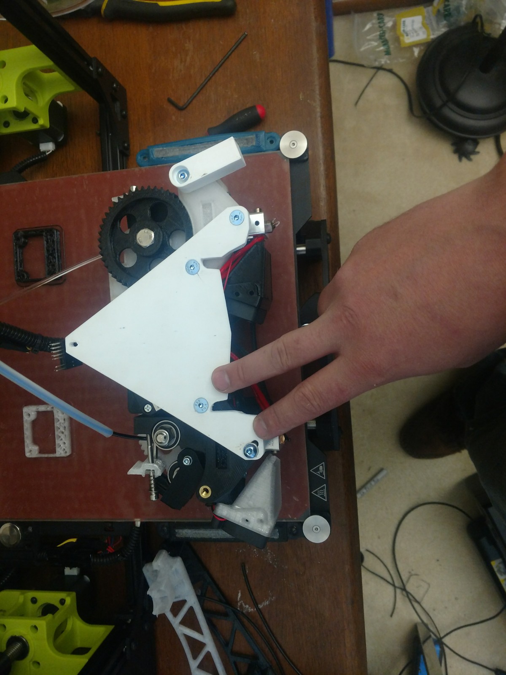
media/photo/setup_guide_photos/IMG_20171006_081428340.jpg
