coloradoprintingproject/twoolhead/(threads)

Thread 1 (2018-09-04):

Unable to compile with Arduino 1.8.5

chilicoke, 2018-09-04:
Hello, I've been following your project and working on building similar of my own and would love to use your firmware as reference/testing.

However I've ran into issue compiling the firmware with Arduino 1.8.5 with error message below, please advise, thank you.
[twoolhead taz6 compile error.txt](https://github.com/coloradoprintingproject/twoolhead/files/2350029/twoolhead.taz6.compile.error.txt)
