coloradoprintingproject/twoolhead/firmware_twoolhead_TAZ5/Marlin_twoolhead_TAZ6/Configuration.h

#define CONFIGURATION_H
#include "boards.h"
#define STRING_VERSION_CONFIG_H __DATE__ " " __TIME__ // build date and time
#define STRING_CONFIG_H_AUTHOR "(none, default config)" // Who made the changes.
#define SERIAL_PORT 0
#define BAUDRATE 250000
  #define MOTHERBOARD BOARD_RAMBO
 #define CUSTOM_MENDEL_NAME "TWAZ"
#define UUID "845f003c-aebd-4e53-a6b9-7d0984fde609"
#define EXTRUDERS 2
#define POWER_SUPPLY 1
#define TEMP_SENSOR_0 5
#define TEMP_SENSOR_1 5
#define TEMP_SENSOR_BED 7
#define MAX_REDUNDANT_TEMP_SENSOR_DIFF 10
#define TEMP_RESIDENCY_TIME 0.5  // (seconds)
#define TEMP_HYSTERESIS 10       // (degC) range of +/- temperatures considered "close" to the target one
#define TEMP_WINDOW     10       // (degC) Window around target to start the residency timer x degC early.
#define TEMP_BED_RESIDENCY_TIME 0.5  // (seconds)
#define TEMP_BED_HYSTERESIS 5       // (degC) range of +/- temperatures considered "close" to the target one
#define TEMP_BED_WINDOW     5       // (degC) Window around target to start the residency timer x degC early.
#define HEATER_0_MINTEMP 5
#define HEATER_1_MINTEMP 5
#define HEATER_2_MINTEMP 5
#define BED_MINTEMP 5
#define HEATER_0_MAXTEMP 305
#define HEATER_1_MAXTEMP 305
#define HEATER_2_MAXTEMP 305
#define BED_MAXTEMP 150
#define PIDTEMP
#define BANG_MAX 255 // limits current to nozzle while in bang-bang mode; 255=full current
#define PID_MAX BANG_MAX // limits current to nozzle while PID is active (see PID_FUNCTIONAL_RANGE below); 255=full current
  #define PID_FUNCTIONAL_RANGE 10 // If the temperature difference between the target temperature and the actual temperature
  #define PID_INTEGRAL_DRIVE_MAX PID_MAX  //limit for the integral term
  #define K1 0.95 //smoothing factor within the PID
  #define PID_dT ((OVERSAMPLENR * 10.0)/(F_CPU / 64.0 / 256.0)) //sampling period of the temperature routine
      #define DEFAULT_Kp 28.79
      #define DEFAULT_Ki 1.91
      #define DEFAULT_Kd 108.51
#define PIDTEMPBED
#define MAX_BED_POWER 206 // limits duty cycle to bed; 255=full current
    #define DEFAULT_bedKp 162
    #define DEFAULT_bedKi 17
    #define DEFAULT_bedKd 378
#define PREVENT_DANGEROUS_EXTRUDE
#define PREVENT_LENGTHY_EXTRUDE
#define EXTRUDE_MINTEMP 120
#define EXTRUDE_MAXLENGTH (X_MAX_LENGTH+Y_MAX_LENGTH) //prevent extrusion of very large distances.
#define THERMAL_RUNAWAY_PROTECTION_PERIOD 15 //in seconds
#define THERMAL_RUNAWAY_PROTECTION_HYSTERESIS 30 // in degree Celsius
#define THERMAL_RUNAWAY_PROTECTION_BED_PERIOD 15 //in seconds
#define THERMAL_RUNAWAY_PROTECTION_BED_HYSTERESIS 10 // in degree Celsius
#define ENDSTOPPULLUPS // Comment this out (using // at the start of the line) to disable the endstop pullup resistors
  #define ENDSTOPPULLUP_XMAX
  #define ENDSTOPPULLUP_YMAX
  #define ENDSTOPPULLUP_ZMAX
  #define ENDSTOPPULLUP_XMIN
  #define ENDSTOPPULLUP_YMIN
  #define ENDSTOPPULLUP_ZMIN
  #define ENDSTOPPULLUP_ZPROBE
const bool X_MIN_ENDSTOP_INVERTING = true; // set to true to invert the logic of the endstop.
const bool Y_MIN_ENDSTOP_INVERTING = true; // set to true to invert the logic of the endstop.
const bool Z_MIN_ENDSTOP_INVERTING = true; // set to true to invert the logic of the endstop.
const bool Z_PROBE_ENDSTOP_INVERTING = true; // set to true to invert the logic of the endstop.
const bool X_MAX_ENDSTOP_INVERTING = true; // set to true to invert the logic of the endstop.
const bool Y_MAX_ENDSTOP_INVERTING = true; // set to true to invert the logic of the endstop. USED FOR EMI ATTENUATION!
const bool Z_MAX_ENDSTOP_INVERTING = true; // set to true to invert the logic of the endstop.
#if defined(COREXY) && !defined(DISABLE_MAX_ENDSTOPS)
  #define DISABLE_MAX_ENDSTOPS
#endif
#define X_ENABLE_ON 0
#define Y_ENABLE_ON 0
#define Z_ENABLE_ON 0
#define E_ENABLE_ON 0 // For all extruders
#define DISABLE_X false
#define DISABLE_Y false
#define DISABLE_Z false
#define DISABLE_E false // For all extruders
#define DISABLE_INACTIVE_EXTRUDER false //disable only inactive extruders and keep active extruder enabled
#define INVERT_X_DIR false    // for LulzBot set to false
#define INVERT_Y_DIR true    // for LulzBot set to true
#define INVERT_Z_DIR false     // for LulzBot set to false
#define INVERT_E0_DIR true   // for standard LulzBot hotends set to true
#define INVERT_E1_DIR true    // for standard LulzBot hotends set to true
#define INVERT_E2_DIR true   // for standard LulzBot hotends set to true
#define X_HOME_DIR -1
#define Y_HOME_DIR -1
#define Z_HOME_DIR -1
#define min_software_endstops true // If true, axis won't move to coordinates less than HOME_POS.
#define max_software_endstops true  // If true, axis won't move to coordinates greater than the defined lengths below.
#define X_MAX_POS 145
#define X_MIN_POS 0
#define Y_MAX_POS 275
#define Y_MIN_POS 0
#define Z_MAX_POS 250
#define Z_MIN_POS 0
#define X_MAX_LENGTH (X_MAX_POS - X_MIN_POS)
#define Y_MAX_LENGTH (Y_MAX_POS - Y_MIN_POS)
#define Z_MAX_LENGTH (Z_MAX_POS - Z_MIN_POS)
#define ENABLE_AUTO_BED_LEVELING // Delete the comment to enable (remove // at the start of the line)
#define Z_PROBE_REPEATABILITY_TEST  // If not commented out, Z-Probe Repeatability test will be included if Auto Bed Leveling is Enabled.
  #define AUTO_BED_LEVELING_GRID
    #define LEFT_PROBE_BED_POSITION -9
    #define RIGHT_PROBE_BED_POSITION 138
    #define BACK_PROBE_BED_POSITION 289
    #define FRONT_PROBE_BED_POSITION -9
    #define AUTO_BED_LEVELING_GRID_POINTS 2
  #define X_PROBE_OFFSET_FROM_EXTRUDER 0
  #define Y_PROBE_OFFSET_FROM_EXTRUDER 0
  #define Z_PROBE_OFFSET_FROM_EXTRUDER -1.5
  #define Z_RAISE_BEFORE_HOMING 5       // (in mm) Raise Z before homing (G28) for Probe Clearance.
  #define Z_RAISE_AFTER_HOMING 10       // Raise Z after homing on a LulzBot TAZ 6 with a mometary switch.
  #define XY_TRAVEL_SPEED 6000         // X and Y axis travel speed between probes, in mm/min
  #define Z_RAISE_BEFORE_PROBING 5    //How much the extruder will be raised before traveling to the first probing point.
  #define Z_RAISE_BETWEEN_PROBINGS 5  //How much the extruder will be raised when traveling from between next probing points
  #define Z_SAFE_HOMING   // This feature is meant to avoid Z homing with probe outside the bed area.
    #define Z_SAFE_HOMING_X_POINT (10)    // X point for Z homing when homing all axis (G28)
    #define Z_SAFE_HOMING_Y_POINT (10)    // Y point for Z homing when homing all axis (G28)
    #if X_PROBE_OFFSET_FROM_EXTRUDER < 0
      #if (-(X_PROBE_OFFSET_FROM_EXTRUDER * AUTO_BED_LEVELING_GRID_POINTS) >= (RIGHT_PROBE_BED_POSITION - LEFT_PROBE_BED_POSITION))
	     #error "The X axis probing range is not enough to fit all the points defined in AUTO_BED_LEVELING_GRID_POINTS"
	  #endif
	#else
      #if ((X_PROBE_OFFSET_FROM_EXTRUDER * AUTO_BED_LEVELING_GRID_POINTS) >= (RIGHT_PROBE_BED_POSITION - LEFT_PROBE_BED_POSITION))
	     #error "The X axis probing range is not enough to fit all the points defined in AUTO_BED_LEVELING_GRID_POINTS"
	  #endif
	#endif
    #if Y_PROBE_OFFSET_FROM_EXTRUDER < 0
      #if (-(Y_PROBE_OFFSET_FROM_EXTRUDER * AUTO_BED_LEVELING_GRID_POINTS) >= (BACK_PROBE_BED_POSITION - FRONT_PROBE_BED_POSITION))
	     #error "The Y axis probing range is not enough to fit all the points defined in AUTO_BED_LEVELING_GRID_POINTS"
	  #endif
	#else
      #if ((Y_PROBE_OFFSET_FROM_EXTRUDER * AUTO_BED_LEVELING_GRID_POINTS) >= (BACK_PROBE_BED_POSITION - FRONT_PROBE_BED_POSITION))
	     #error "The Y axis probing range is not enough to fit all the points defined in AUTO_BED_LEVELING_GRID_POINTS"
	  #endif
	#endif
#define MANUAL_X_HOME_POS 0
#define MANUAL_Y_HOME_POS 0
#define MANUAL_Z_HOME_POS 0
#define NUM_AXIS 4 // The axis order in all axis related arrays is X, Y, Z, E
#define HOMING_FEEDRATE {50*60, 50*60, 8*60, 0}  // set the homing speeds (mm/min)
#define DEFAULT_AXIS_STEPS_PER_UNIT   {100.5,100.5,1600,830}  // default steps per unit for LulzBot TAZ
#define DEFAULT_MAX_FEEDRATE          {800, 800, 3, 40}    // (mm/sec)
#define DEFAULT_MAX_ACCELERATION      {9000,9000,100,10000}    // X, Y, Z, E maximum start speed for accelerated moves.
#define DEFAULT_ACCELERATION          500    // X, Y, Z and E max acceleration in mm/s^2 for printing moves
#define DEFAULT_RETRACT_ACCELERATION  3000   // X, Y, Z and E max acceleration in mm/s^2 for retracts
#define DEFAULT_XYJERK                8.0    // (mm/sec)
#define DEFAULT_ZJERK                 0.4     // (mm/sec)
#define DEFAULT_EJERK                 10.0    // (mm/sec)
#define TRACK_LAYER
#define CUSTOM_M_CODES
  #define CUSTOM_M_CODE_SET_Z_PROBE_OFFSET 851
  #define Z_PROBE_OFFSET_RANGE_MIN -2
  #define Z_PROBE_OFFSET_RANGE_MAX 0
#define EEPROM_SETTINGS
#define EEPROM_CHITCHAT
#define PLA_PREHEAT_HOTEND_TEMP 205
#define PLA_PREHEAT_HPB_TEMP 60
#define PLA_PREHEAT_FAN_SPEED 0   // Insert Value between 0 and 255
#define ABS_PREHEAT_HOTEND_TEMP 240
#define ABS_PREHEAT_HPB_TEMP 110
#define ABS_PREHEAT_FAN_SPEED 0   // Insert Value between 0 and 255
#define SD_CHECK_AND_RETRY // Use CRC checks and retries on the SD communication
#define REPRAP_DISCOUNT_FULL_GRAPHIC_SMART_CONTROLLER
 #define DOGLCD
 #define U8GLIB_ST7920
 #define REPRAP_DISCOUNT_SMART_CONTROLLER
 #define ULTIPANEL
 #define NEWPANEL
  #define SDSUPPORT
  #define ULTRA_LCD
    #define LCD_WIDTH 20
    #define LCD_HEIGHT 5
#  define DEFAULT_LCD_CONTRAST 32
#define FAST_PWM_FAN
#define SOFT_PWM_SCALE 0
#define FILAMENT_SENSOR_EXTRUDER_NUM	0  //The number of the extruder that has the filament sensor (0,1,2)
#define MEASUREMENT_DELAY_CM			14  //measurement delay in cm.  This is the distance from filament sensor to middle of barrel
#define DEFAULT_NOMINAL_FILAMENT_DIA  3.0  //Enter the diameter (in mm) of the filament generally used (3.0 mm or 1.75 mm) - this is then used in the slicer software.  Used for sensor reading validation
#define MEASURED_UPPER_LIMIT          3.30  //upper limit factor used for sensor reading validation in mm
#define MEASURED_LOWER_LIMIT          1.90  //lower limit factor for sensor reading validation in mm
#define MAX_MEASUREMENT_DELAY			20  //delay buffer size in bytes (1 byte = 1cm)- limits maximum measurement delay allowable (must be larger than MEASUREMENT_DELAY_CM  and lower number saves RAM)
#define DEFAULT_MEASURED_FILAMENT_DIA  DEFAULT_NOMINAL_FILAMENT_DIA  //set measured to nominal initially
#include "Configuration_adv.h"
#include "thermistortables.h"
