coloradoprintingproject/twoolhead/firmware/v1.0_campaign-twoolheads/Marlin_twoolhead_v1_0_TAZ5/Configuration_adv.h

#define CONTROLLERFAN_PIN FAN2_PIN //Pin used for the fan to cool controller (-1 to disable)
#define EXTRUDER_0_AUTO_FAN_PIN   -1
#define EXTRUDER_1_AUTO_FAN_PIN   -1
#define EXTRUDER_2_AUTO_FAN_PIN   -1
#define X_HOME_RETRACT_MM 5
#define Y_HOME_RETRACT_MM 5
#define Z_HOME_RETRACT_MM 2
#define MICROSTEP1 LOW,LOW
#define MICROSTEP2 HIGH,LOW
#define MICROSTEP4 LOW,HIGH
#define MICROSTEP8 HIGH,HIGH
#define MICROSTEP16 HIGH,HIGH
#define MICROSTEP_MODES {16,16,16,16,16} // [1,2,4,8,16]
#define DIGIPOT_MOTOR_CURRENT {175,175,200,160,160} // Values 0-255 (RAMBO 135 = ~0.75A, 185 = ~1A)
#define DIGIPOT_I2C_MOTOR_CURRENTS {1.0, 1.0, 1.0, 1.0, 1.0, 1.0, 1.0, 1.0}
