coloradoprintingproject/twoolhead/(commit log)

2017-07-11 stl's for early twoolhead prototype added
    the twoolhead_mount and x_min_hitter_thing are the only 2 unique parts to the twoolhead, ther rest of the parts are from the Gladiola version of the LulzBot mini (http://devel.lulzbot.com/mini/accessories/dodo/).
    FreeCAD source for the switch hitter thing is included as well as the last source for the twoolhead mount plate, although the part has since been HEAVILY modified in blender, so it's best to use the stl 1.03b. I'll probably do a clean redraw in freeCAD when I'm happy with how everything is lining up.
    [twoolhead_mount_plate_v1.03b.stl, twoolhead_v1.01.FCStd, x_min_hitter_thing_v0.1.FCStd, x_min_hitter_thing_v0.1.stl]
2017-07-11 Firmware added to repo
    This is the first shot at working parallel printing firmware for the TAZ 6, beware of bugs / dragons.
    [Configuration.h, Configuration_adv.h]
2017-07-20 reorganised into folders
    firmware and other files were a mess, are now organised into folders. woot
    [Configuration.h, Configuration_adv.h, twoolhead_mount_plate_v1.03b.stl, twoolhead_v1.01.FCStd, x_min_hitter_thing_v0.1.FCStd, x_min_hitter_thing_v0.1.stl]
2017-07-21 twoolhead embeefened, render of incomplete assembly added
2017-07-27 embeefened parts added to repo
    upper and lower braces designed in blender and added to repo
    [blenderized_mini_extruder_mount.stl, heatsink_fan_duct_brace_for_bool.stl, heatsink_fan_duct_brace_for_bool_v0.1.FCStd, two-exturder_brace_0.1.FCStd, two_extruder_brace_0.2b.stl, twoolhead_heatsink_fan_brace_0.2b.stl]
2017-08-30 bom added to repo
    it's a bom, and it's in the repo now
    [twoolhead_bom.ods]
2017-09-27 BOM updated with printed part pricing and COGS calculator
    This is for standard twoolhead only
    [twoolhead_bom.ods]
2017-09-27 twoolhead BOM/COGS/funding calc updated
    [twoolhead_bom.ods]
2017-10-01 TAZ 5 firmware added - this is untested atm
    [Configuration.h, Configuration_adv.h, twoolhead_bom.ods]
2017-10-05 stepper current updated to OMC stepper value in both firmwares
    [Configuration.h, Configuration_adv.h]
2017-10-10 right side woper mount source and stl added
    [right_side_wiper_mount_v1.1.fcstd, right_side_wiper_wount_v1.1.stl]
2017-10-11 HT print profile added
2017-10-11 printed part cost calculator updated with overhead and energy costs
    [twoolhead_bom.ods]
2017-10-11 twoolhead+taz vs injection molding comparison added
    [twaz_vs_injection-molding.ods]
2017-10-14 Add files via upload
    taz_5_modifications
    [Configuration.h, Configuration_adv.h]
2017-10-18 stock AO part files added
    [40mm_Fan_grill_final.stl, Motor_NEMA17.stl, blenderized_mini_extruder_mount.stl, heatsink_fan_duct_brace_for_bool.stl, heatsink_fan_duct_brace_for_bool_v0.1.FCStd, herringbone_small_gear-1.1-highres.stl, lrg_herringbone_gear_v1.3.stl, right_side_wiper_mount_v1.1.fcstd]
2017-10-18 twoolhead setup outline modified
    [twaz_vs_injection-molding.ods]
2017-10-18 608 bearing designed and added to production parts
    [608zz_bearing.fcstd, 608zz_bearing.stl]
2017-10-18 blender mockup and new twoolhead brace added
    [beefy_extruder_idler_v0.4.stl, beefy_idler_latch_v2.2.stl, cross_extruder_brace.fcstd, cross_extruder_brace.stl, extruder_fan_mount_v2.1_mini.stl, hobbed_bolt_mockup.fcstd, hobbed_bolt_mockup.stl, opah_extruder_body_v0.2.stl]
2017-11-07 updated firmware uploaded
    The standard TAZ 6 firmware had the extruder motor current limit raised slightly. the new stock_dual_motor branch was created for people who want to use the stock LulzBot half height motors that come on the Dual v2 and FlexyDually v2
    [Configuration.h, Configuration_adv.h]
2017-11-16 stilty extruder mount file added to fix clearance issues
    [stilty-extruder-mount.blend, stilty-extruder-mount.stl]
2017-11-16 export issue with cross extruder brace fixed
    [cross_extruder_brace_1.0b.stl, cross_extruder_brace_1.1b.stl]
2017-11-20 ABS fast profile for 0.8mm nozz version added
2017-11-20 TAZ 6 print profiles updated
    [stilty-extruder-mount.blend, stilty-extruder-mount.stl]
2017-11-20 print-profiles directory restructured
2017-11-23 Broken firmware removed, firmware restrustured in repo
    [Configuration.h, Configuration_adv.h]
2017-12-02 upper extruder brace modified to add more travel
    [cross_extruder_brace.stl, cross_extruder_brace_1.1b.stl, stilty-extruder-mount.blend]
2017-12-06 heatsink fan brace enslottened for better mountability
    [slotty_heatsink_fan_brace.stl]
2017-12-06 custom parts folder reorganized and purged of obsolete files
    [blenderized_mini_extruder_mount.stl, cross_extruder_brace.fcstd, heatsink_fan_duct_brace_for_bool.stl, heatsink_fan_duct_brace_for_bool_v0.1.FCStd, right_side_wiper_mount.fcstd, right_side_wiper_mount.stl, stilty-extruder-mount.blend, two-exturder_brace_0.1.FCStd]
2017-12-18 upper extruder brace modified for anti-detentability
    [upper_extruder_brace.stl]
2017-12-18 added extruder washer stl from lulzbot's repo
    [extruder_washer_v3.0-x16.stl, jonaskuehling_gregs-wade-ao-v3-washer-x7.stl]
2017-12-21 firmware section updated to seperate 0.9 versions from 1.0 twoolheads
    [Configuration.h, Configuration_adv.h]
2017-12-22 TAZ 5 firmware uploaded for the Twoolhead v1.0
    [Configuration.h, Configuration_adv.h]
2017-12-27 print profile folder names changed to reflect the 2 different versions of cura lulzbot edition
2018-01-04 bom updated with final printed part weights and print times
    [twoolhead_bom.ods]
2018-01-04 x-min switch revised to be more roundy
    [x_min_switch_hitter_thing.FCStd, x_min_switch_hitter_thing.stl]
2018-01-12 part price calculator updated, start and end gcode files reorganized for clarity
    [twoolhead_bom.ods]
2018-03-22 new photos added. they're purple!
    [twoolhead_bom.ods]
2018-04-04 single printhead comparison added to bom, v1.1 photo added
    [twoolhead_bom.ods]
2018-05-15 twoolhead BOM updated to reflect the change to E3D hotends
    [twoolhead_bom.ods]
2018-05-15 heatsink fan brace updated to add more clearance and nozzle size labeling
    [heatsink_brace.blend, longblock-mount.blend, longblock-mount.stl, slotty_heatsink_fan_brace_0.5label.stl, slotty_heatsink_fan_brace_0.5mm.stl, slotty_heatsink_fan_brace_0.8mm.stl, slotty_heatsink_fan_brace_1.2mm.stl]
2018-05-16 extrusion fan mount modified for HC clearance, bottom added to right side wiper mount
    [extrusion_fan_with_cutout.stl, right_side_wiper_mount.fcstd, right_side_wiper_mount.stl]
